jitendraphand/aquabot/docs/images/aquabot_front.png

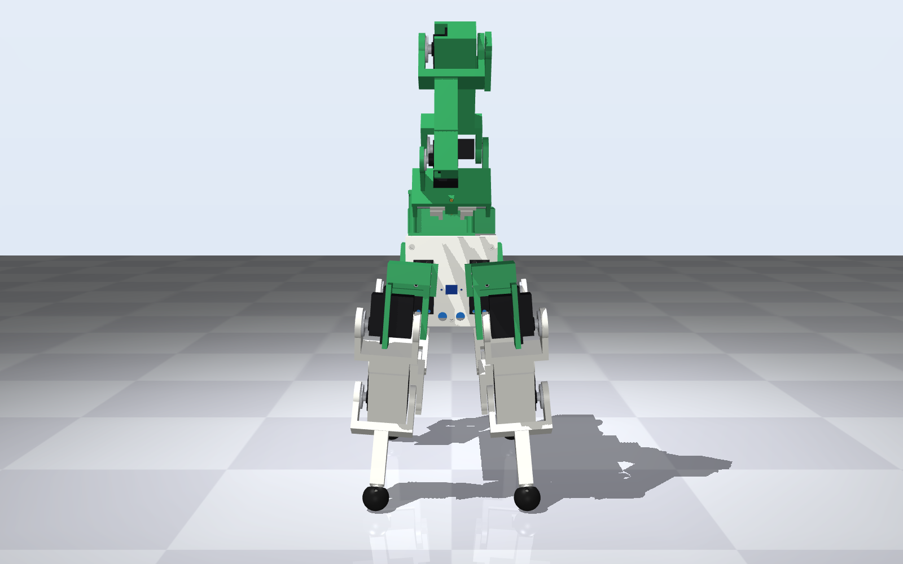
docs/images/aquabot_front.png
