jitendraphand/aquabot/docs/images/aquabot_rear34.png

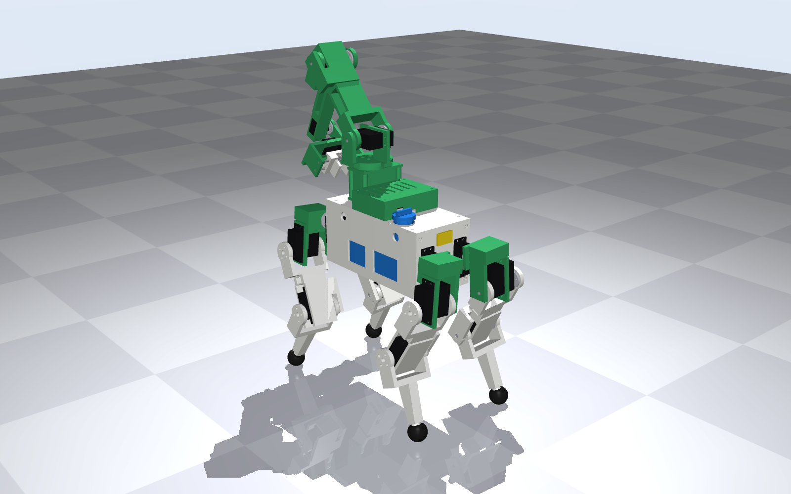
docs/images/aquabot_rear34.png
