jitendraphand/aquabot/docs/images/arm_iso.png

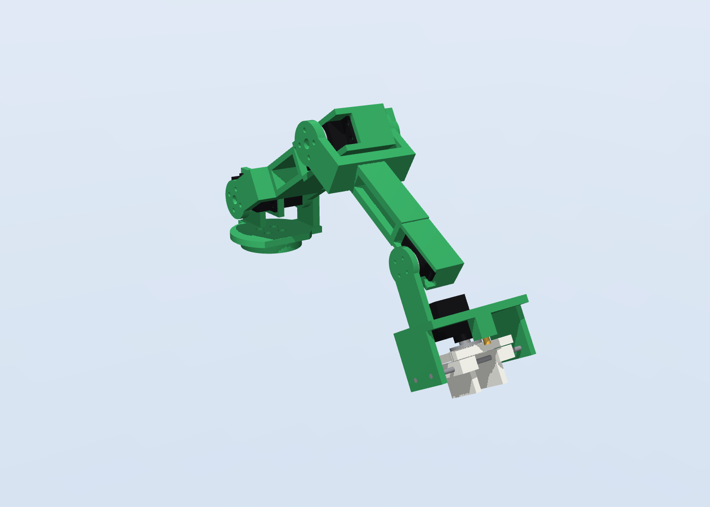
docs/images/arm_iso.png
