jitendraphand/aquabot/docs/images/body_internals_iso.png

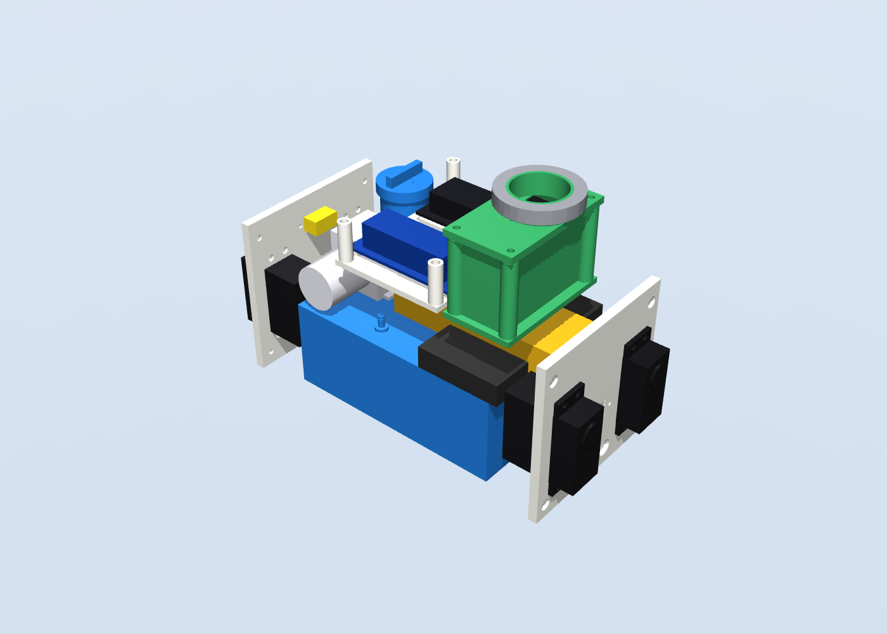
docs/images/body_internals_iso.png
