jitendraphand/aquabot/docs/images/leg_FL_side.png

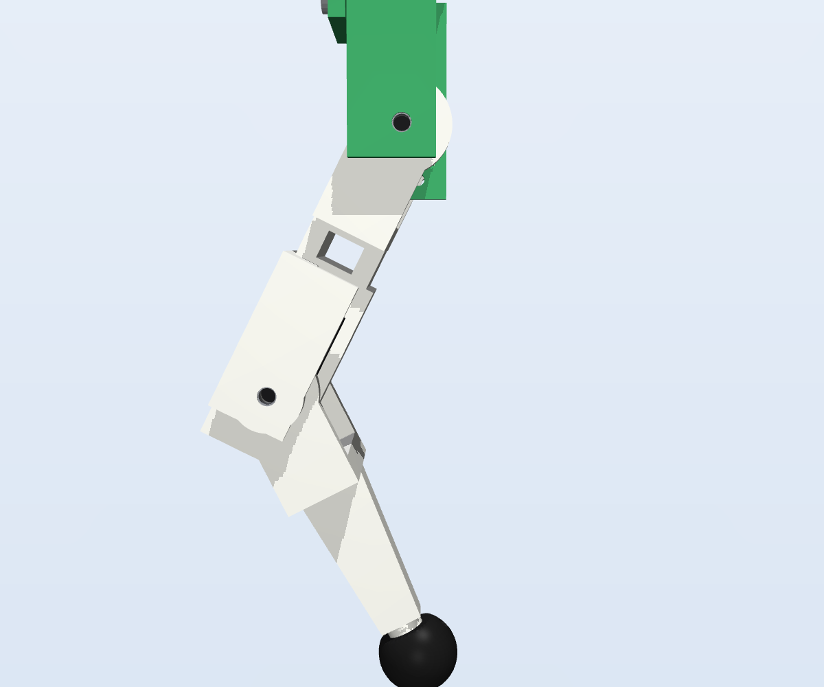
docs/images/leg_FL_side.png
