jitendraphand/aquabot/cad/assembly/arm_assembly.step

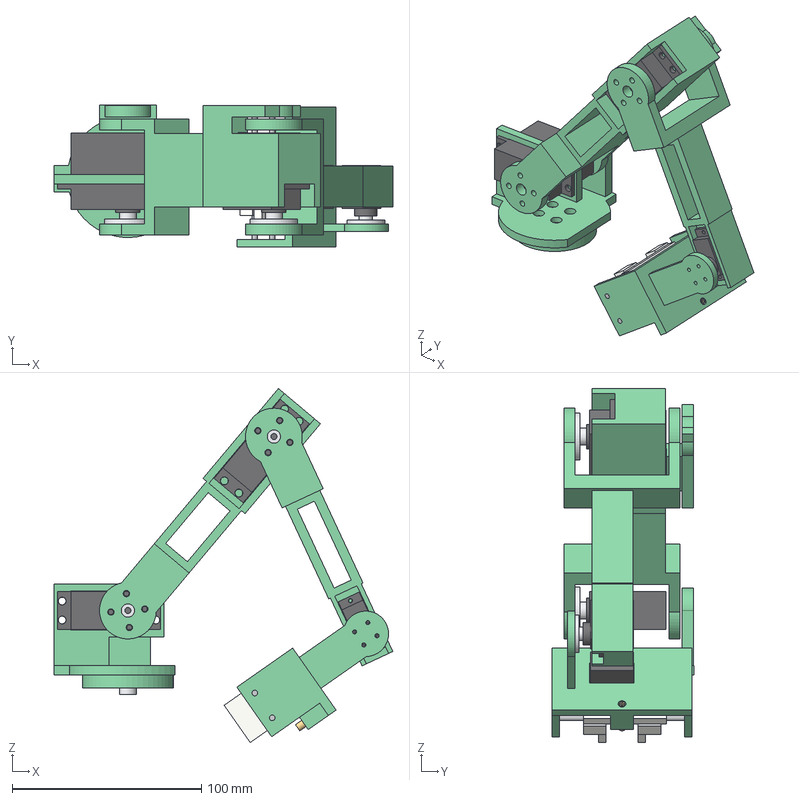
[picture p16: CAD file, 2026-11-04]
cad/assembly/arm_assembly.step
179.0 x 75.0 x 187.1 mm
arm_turntable
horn_arm_yaw x 3
servo_arm_shoulder x 2
bearing_arm_shoulder x 2
upper_arm
forearm
servo_arm_wrist x 2
gripper_base
horn_arm_wrist x 2
rod_gripper_upper x 2
nozzle
gripper_jaw_a x 2
gripper_pinion
