jitendraphand/aquabot/cad/assembly/body_assembly.step

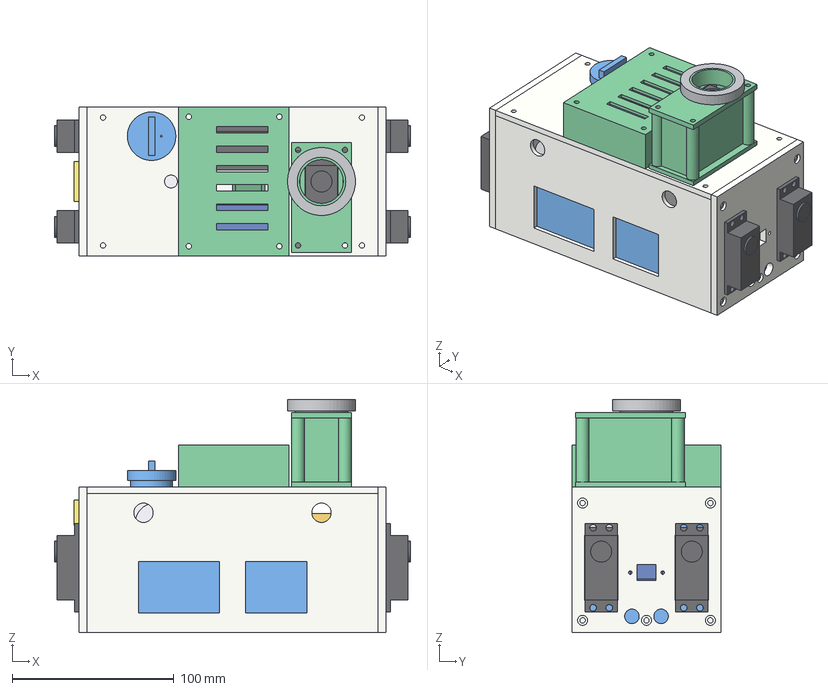
[picture p17: CAD file, 2026-11-04]
cad/assembly/body_assembly.step
220.0 x 92.0 x 144.0 mm
chassis_tub
bulkhead_front
bulkhead_rear
top_deck
tank_body
tank_lid
fill_cap
electronics_tray
electronics_cover
arm_pedestal
arm_bearing_plate
servo_FL_J1 x 5
bearing_yaw
battery
pump
ubec_L x 2
buck_5v
imu
tof
rocker_switch
xt60_port
pca9685
esp32
mosfet
