jitendraphand/aquabot/cad/assembly/aquabot_assembly.step

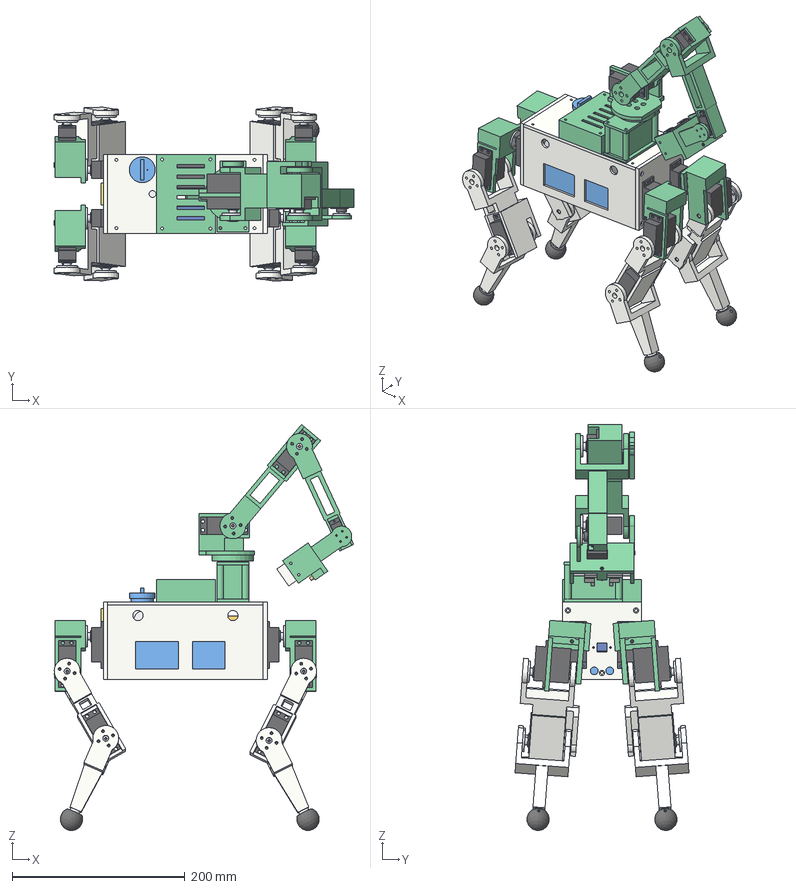
[picture p18: CAD file, 2026-11-04]
cad/assembly/aquabot_assembly.step
347.0 x 201.6 x 470.3 mm
chassis_tub
bulkhead_front
bulkhead_rear
top_deck
tank_body
tank_lid
fill_cap
electronics_tray
electronics_cover
arm_pedestal
arm_bearing_plate
servo_FL_J1 x 15
bearing_yaw
battery
pump
ubec_L x 2
buck_5v
imu
tof
rocker_switch
xt60_port
pca9685
esp32
mosfet
shoulder_bracket_FL x 2
horn_FL_J1 x 15
bearing_FL_J2 x 10
femur_FL x 2
tibia_FL x 2
foot_FL x 4
shoulder_bracket_FR x 2
femur_FR x 2
tibia_FR x 2
arm_turntable
upper_arm
forearm
servo_arm_wrist x 2
gripper_base
horn_arm_wrist x 2
rod_gripper_upper x 2
nozzle
gripper_jaw_a x 2
gripper_pinion
