jitendraphand/aquabot/cad/assembly/leg_FL_assembly.step

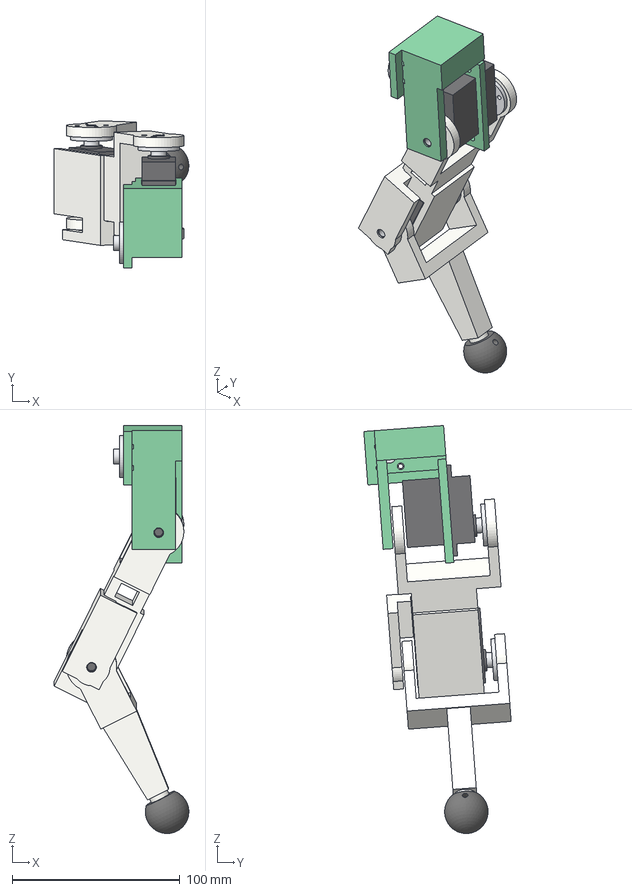
[picture p19: CAD file, 2026-11-04]
cad/assembly/leg_FL_assembly.step
80.4 x 88.0 x 243.5 mm
shoulder_bracket_FL
servo_FL_J2 x 2
horn_FL_J1 x 3
bearing_FL_J2 x 2
femur_FL
tibia_FL
foot_FL
