jitendraphand/aquabot/cad/step/top_deck.step

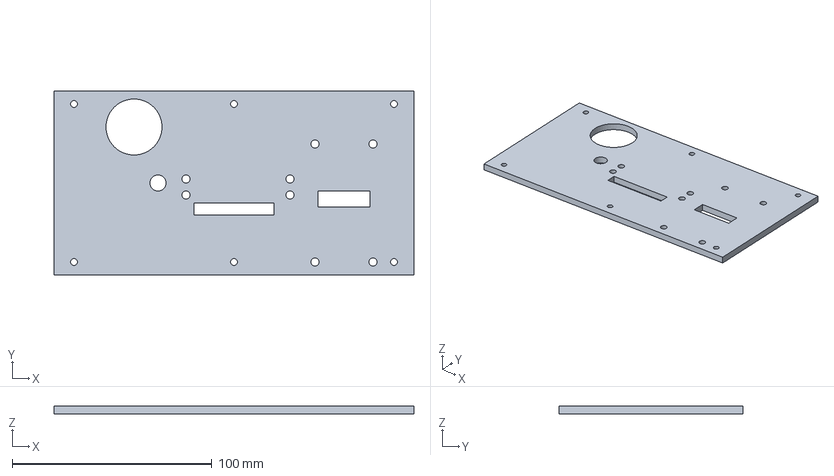
[picture p20: CAD file, 2026-11-04]
cad/step/top_deck.step
180.0 x 92.0 x 4.00 mm
