jitendraphand/aquabot/sim/models/meshes/shoulder_bracket_R.stl

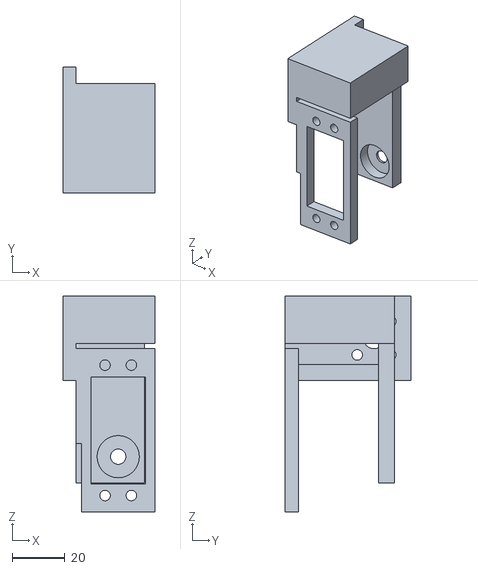
[picture p21: CAD file, 2026-11-04]
sim/models/meshes/shoulder_bracket_R.stl
35.0 x 47.8 x 82.0
