jitendraphand/aquabot/sim/models/urdf/meshes/tank_lid.stl

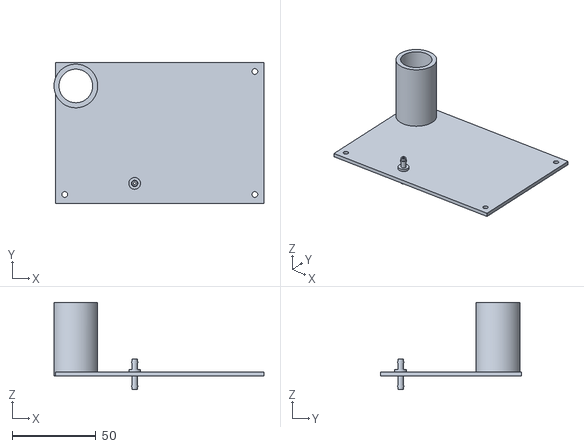
[picture p22: CAD file, 2026-11-04]
sim/models/urdf/meshes/tank_lid.stl
125.0 x 84.0 x 52.0
