jitendraphand/aquabot/cad/step/gripper_pinion.step

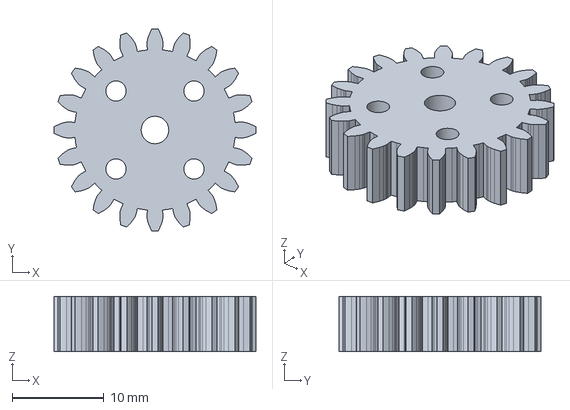
[picture p23: CAD file, 2026-11-04]
cad/step/gripper_pinion.step
22.0 x 22.0 x 6.00 mm
