jitendraphand/aquabot/sim/models/meshes/upper_arm.stl

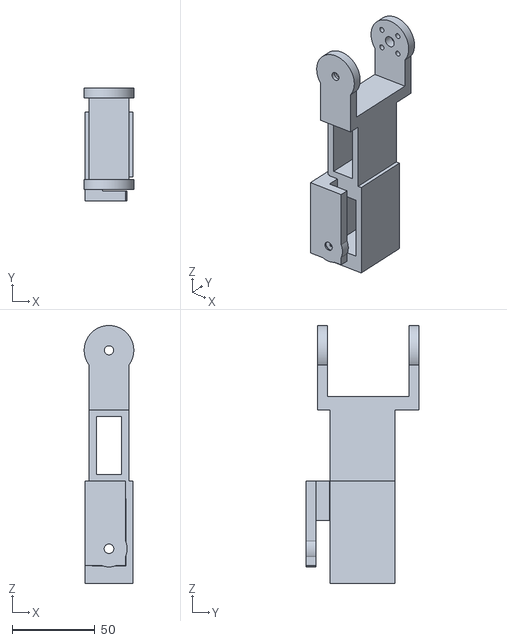
[picture p24: CAD file, 2026-11-04]
sim/models/meshes/upper_arm.stl
30.0 x 68.5 x 156.0
