jitendraphand/aquabot/cad/step/tof_vl53l0x.step

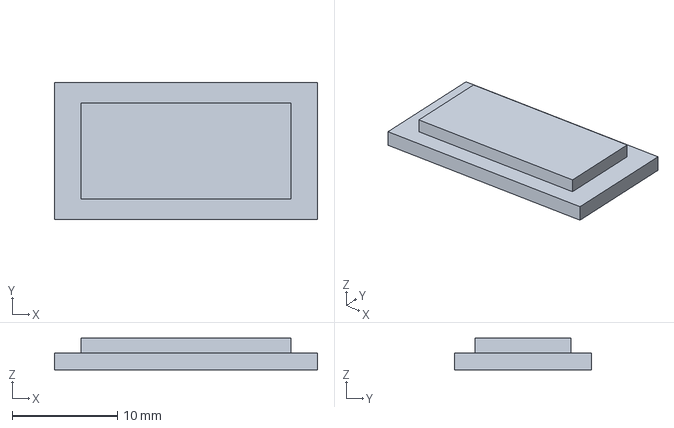
[picture p25: CAD file, 2026-11-04]
cad/step/tof_vl53l0x.step
25.0 x 13.0 x 3.00 mm
