jitendraphand/aquabot/sim/models/meshes/bearing_625.stl

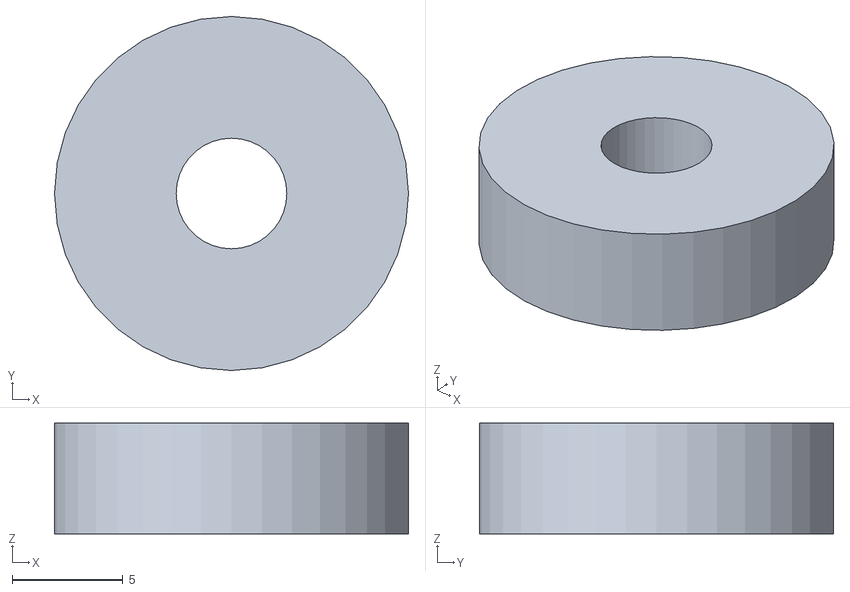
[picture p26: CAD file, 2026-11-04]
sim/models/meshes/bearing_625.stl
16.0 x 16.0 x 5.00
