jitendraphand/aquabot/sim/models/meshes/electronics_cover.stl

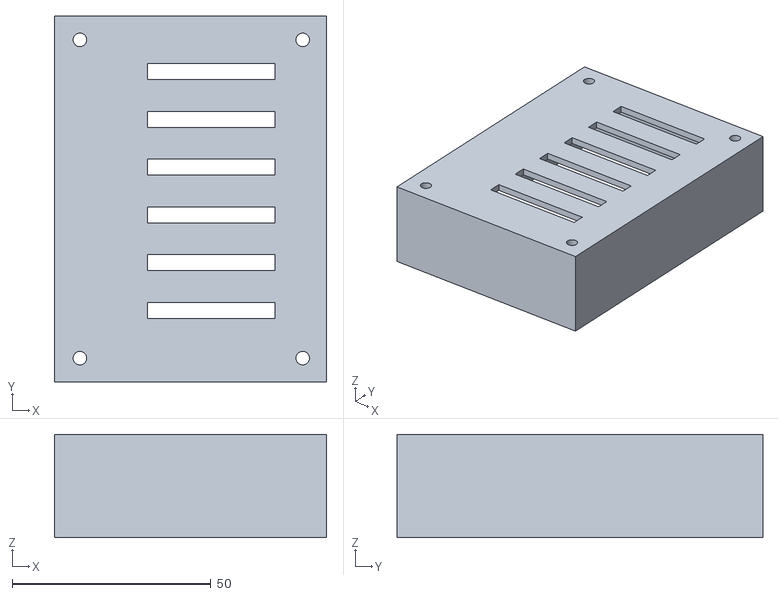
[picture p27: CAD file, 2026-11-04]
sim/models/meshes/electronics_cover.stl
68.4 x 92.0 x 26.0
