jitendraphand/aquabot/sim/models/urdf/meshes/gripper_base.stl

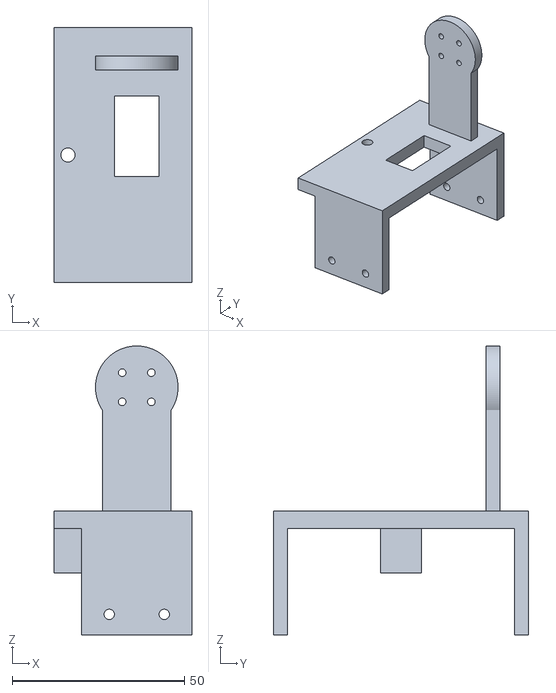
[picture p28: CAD file, 2026-11-04]
sim/models/urdf/meshes/gripper_base.stl
40.0 x 74.0 x 84.0
