jitendraphand/aquabot/cad/step/tibia_L.step

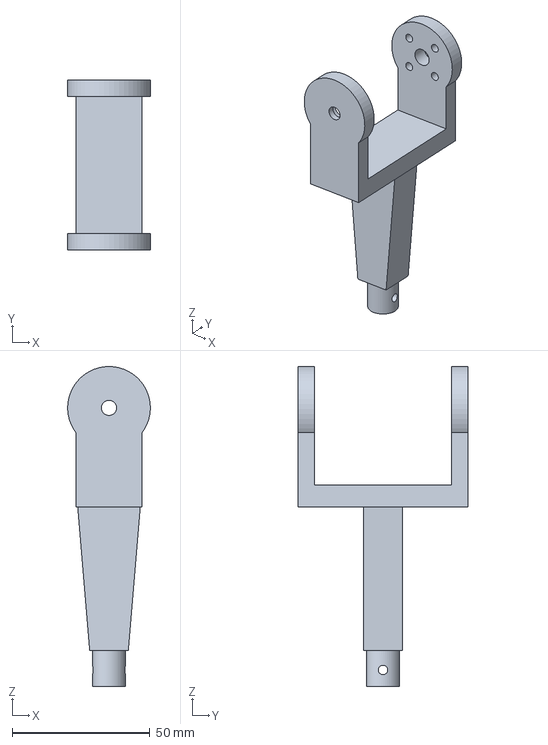
[picture p29: CAD file, 2026-11-04]
cad/step/tibia_L.step
30.0 x 61.5 x 116.0 mm
