jitendraphand/aquabot/sim/models/urdf/meshes/foot_pad.stl

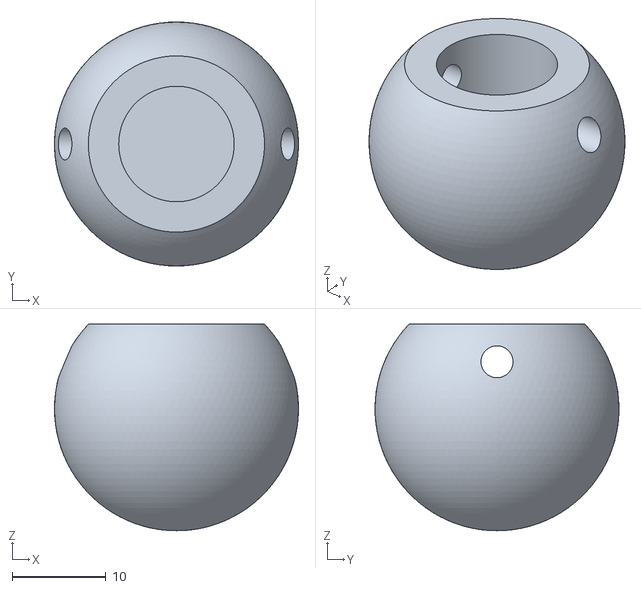
[picture p30: CAD file, 2026-11-04]
sim/models/urdf/meshes/foot_pad.stl
26.0 x 26.0 x 22.0
