jitendraphand/aquabot/cad/step/mosfet_module.step

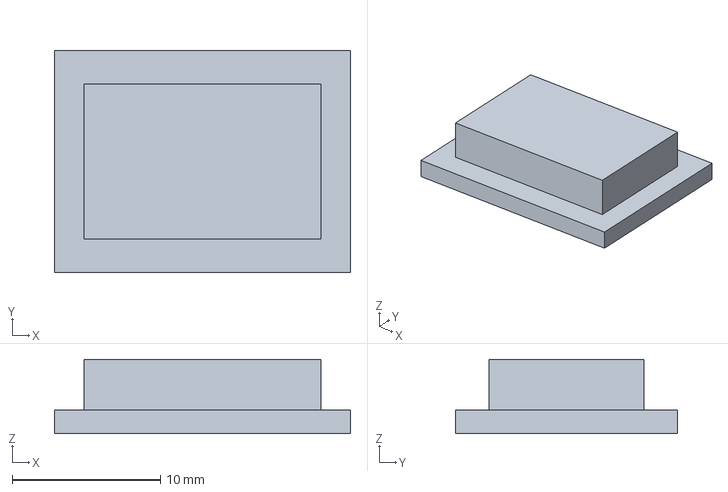
[picture p31: CAD file, 2026-11-04]
cad/step/mosfet_module.step
20.0 x 15.0 x 5.00 mm
