jitendraphand/aquabot/sim/models/meshes/esp32_devkitc.stl

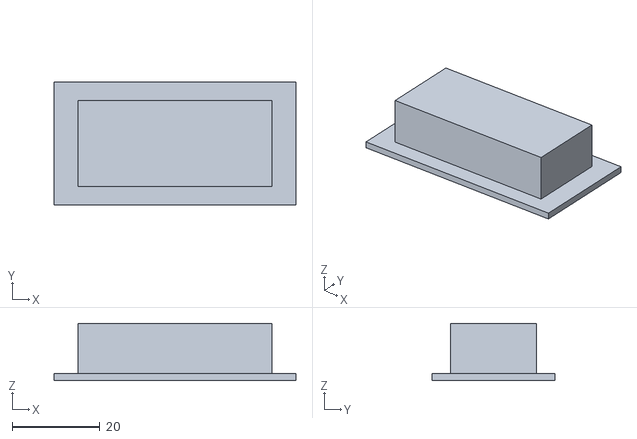
[picture p32: CAD file, 2026-11-04]
sim/models/meshes/esp32_devkitc.stl
55.0 x 28.0 x 13.0
