jitendraphand/aquabot/sim/models/urdf/meshes/bulkhead_front.stl

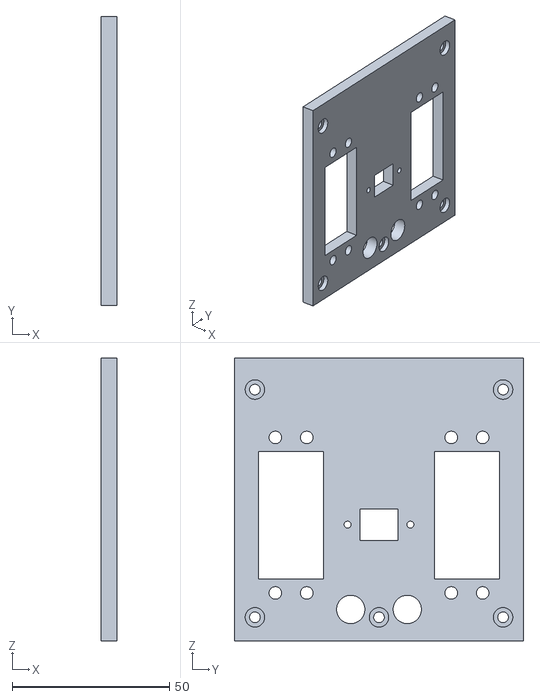
[picture p33: CAD file, 2026-11-04]
sim/models/urdf/meshes/bulkhead_front.stl
5.00 x 92.0 x 90.0
