jitendraphand/aquabot/cad/step/pca9685.step

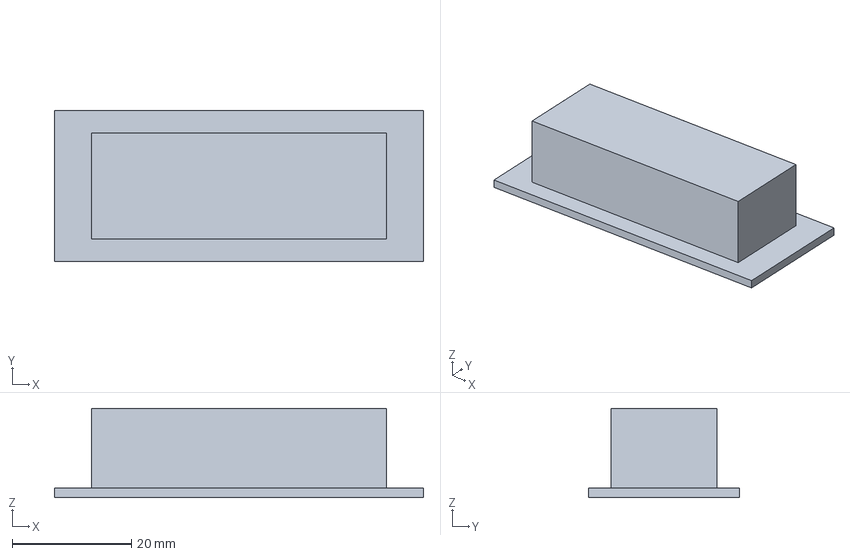
[picture p34: CAD file, 2026-11-04]
cad/step/pca9685.step
62.0 x 25.4 x 15.0 mm
