jitendraphand/aquabot/sim/models/meshes/servo_mg90s.stl

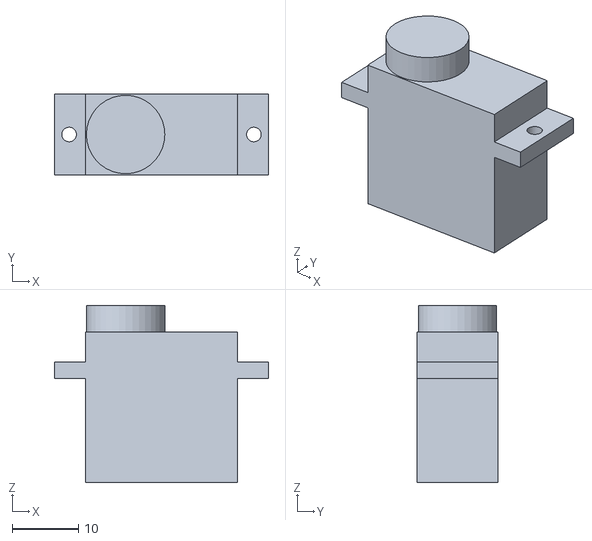
[picture p35: CAD file, 2026-11-04]
sim/models/meshes/servo_mg90s.stl
32.2 x 12.2 x 26.7
