jitendraphand/aquabot/cad/step/ubec_6v_10a.step

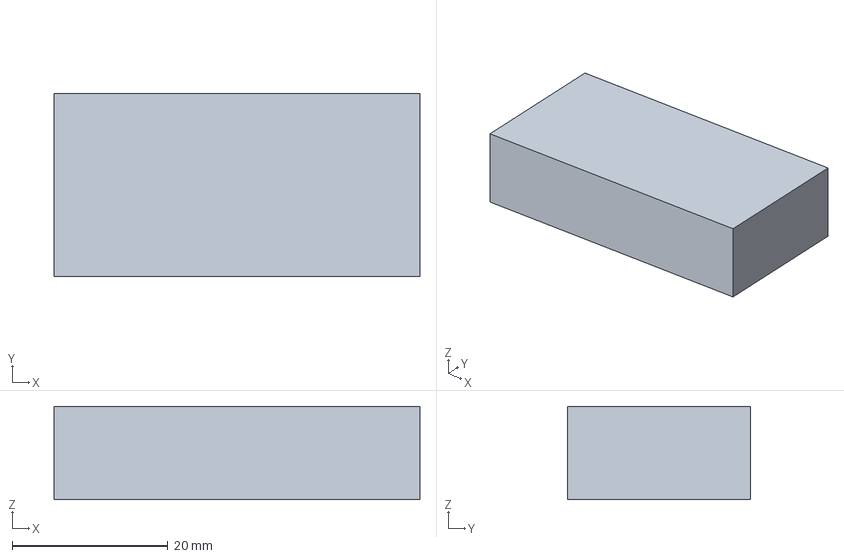
[picture p36: CAD file, 2026-11-04]
cad/step/ubec_6v_10a.step
47.0 x 23.5 x 12.0 mm
