jitendraphand/aquabot/cad/step/arm_bearing_plate.step

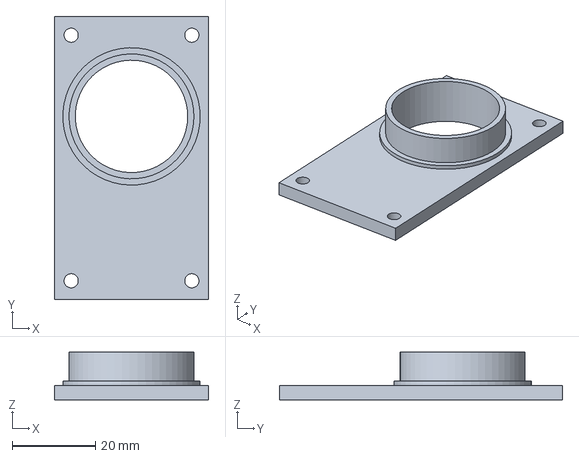
[picture p37: CAD file, 2026-11-04]
cad/step/arm_bearing_plate.step
37.0 x 68.0 x 11.5 mm
