jitendraphand/aquabot/sim/models/urdf/meshes/battery_2s_2200.stl

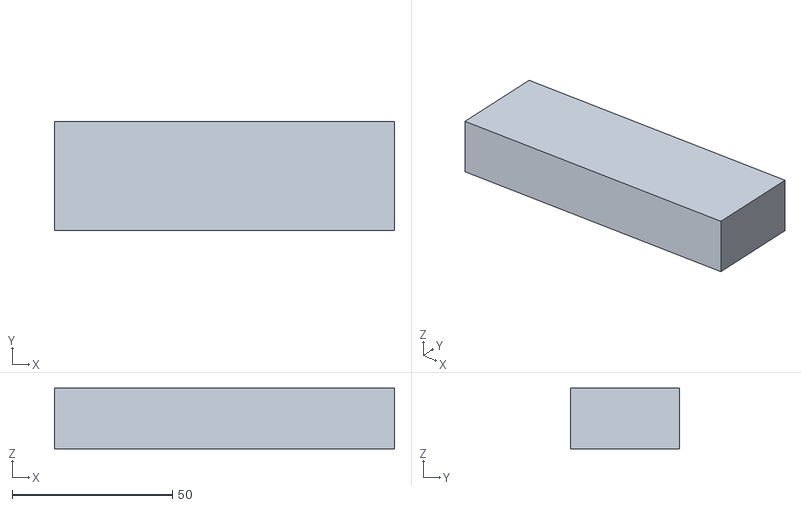
[picture p38: CAD file, 2026-11-04]
sim/models/urdf/meshes/battery_2s_2200.stl
106.0 x 34.0 x 19.0
