jitendraphand/aquabot/cad/step/forearm.step

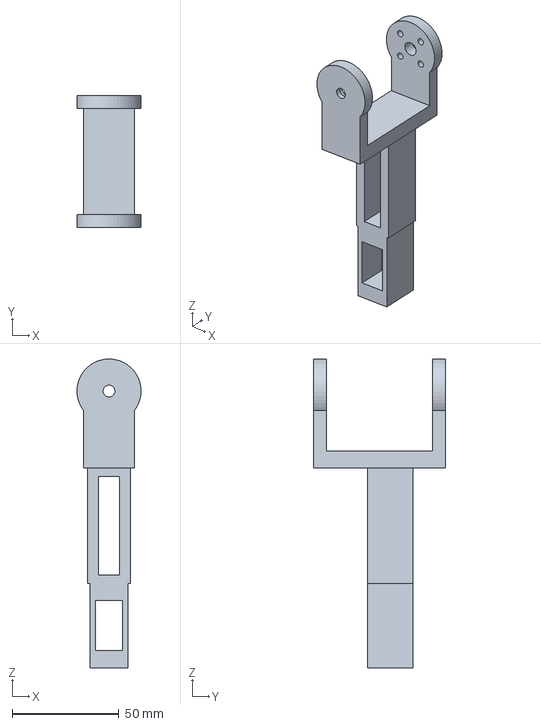
[picture p39: CAD file, 2026-11-04]
cad/step/forearm.step
30.0 x 61.5 x 144.5 mm
