jitendraphand/aquabot/sim/models/meshes/femur_L.stl

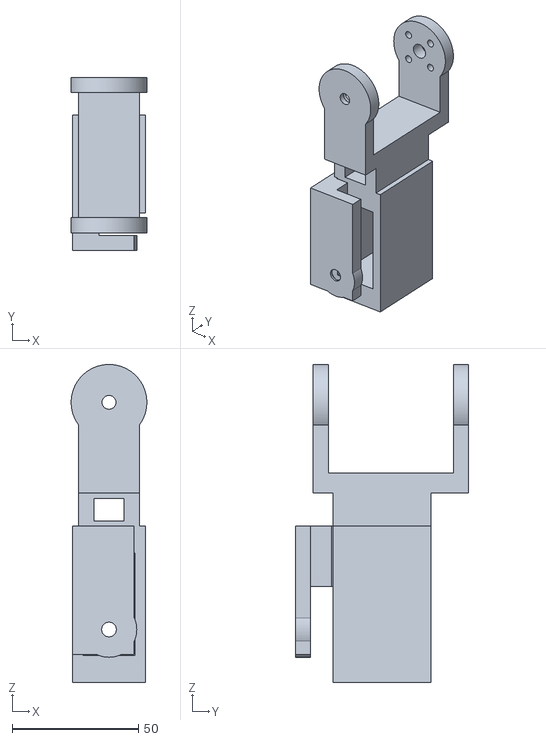
[picture p40: CAD file, 2026-11-04]
sim/models/meshes/femur_L.stl
30.0 x 68.5 x 126.0
