jitendraphand/aquabot/sim/models/urdf/meshes/imu_mpu6050.stl

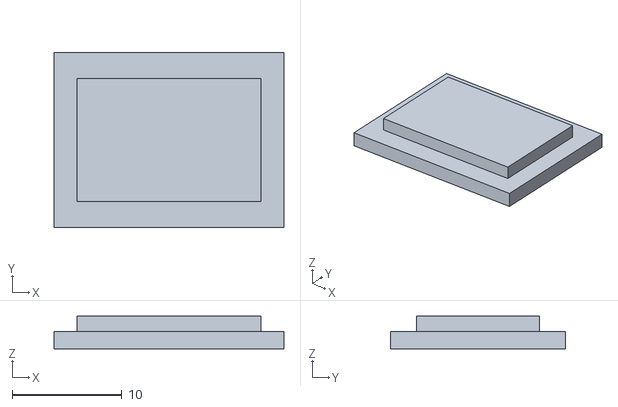
[picture p41: CAD file, 2026-11-04]
sim/models/urdf/meshes/imu_mpu6050.stl
21.0 x 16.0 x 3.00
