jitendraphand/aquabot/cad/step/chassis_tub.step

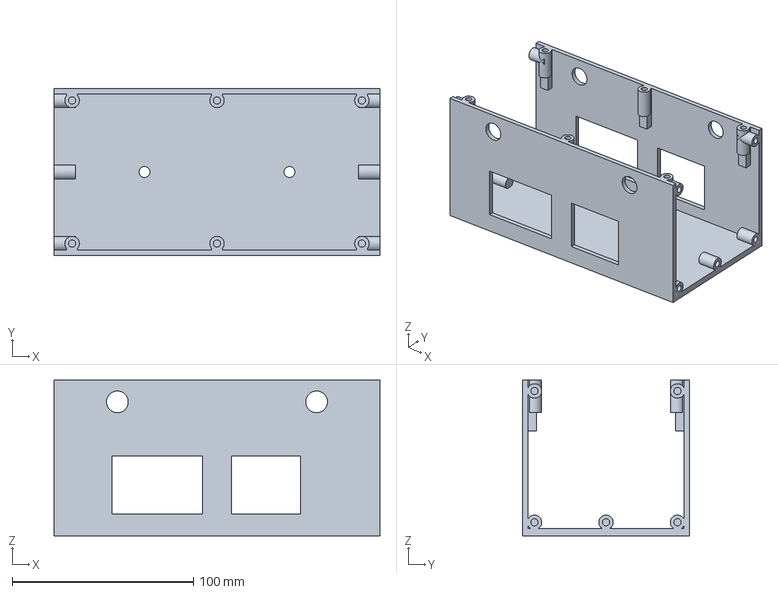
[picture p42: CAD file, 2026-11-04]
cad/step/chassis_tub.step
180.0 x 92.0 x 86.0 mm
