jitendraphand/aquabot/sim/models/urdf/meshes/rocker_switch.stl

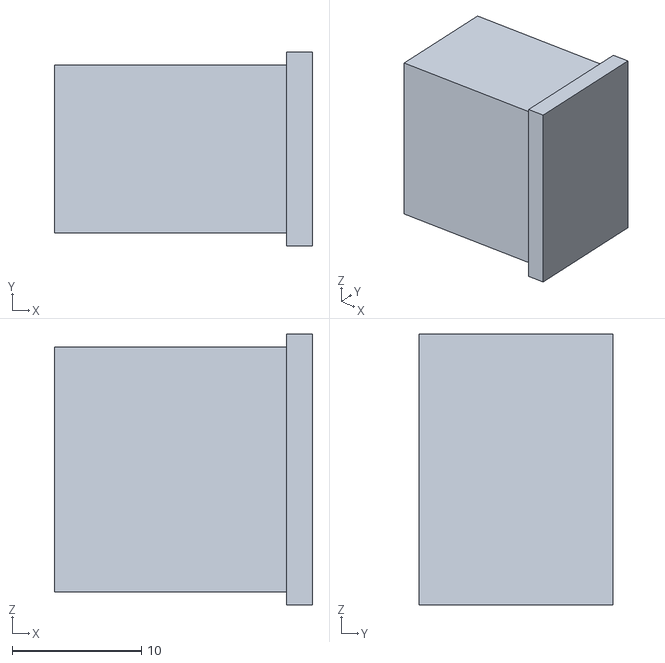
[picture p43: CAD file, 2026-11-04]
sim/models/urdf/meshes/rocker_switch.stl
20.0 x 15.0 x 21.0
