jitendraphand/aquabot/cad/step/servo_ds3218.step

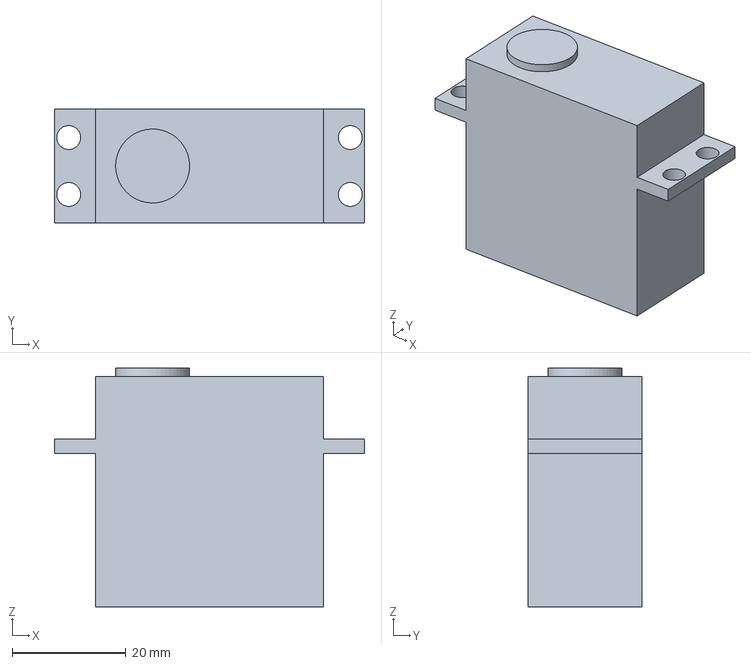
[picture p44: CAD file, 2026-11-04]
cad/step/servo_ds3218.step
54.5 x 20.0 x 42.0 mm
