jitendraphand/aquabot/cad/step/xt60_panel_mount.step

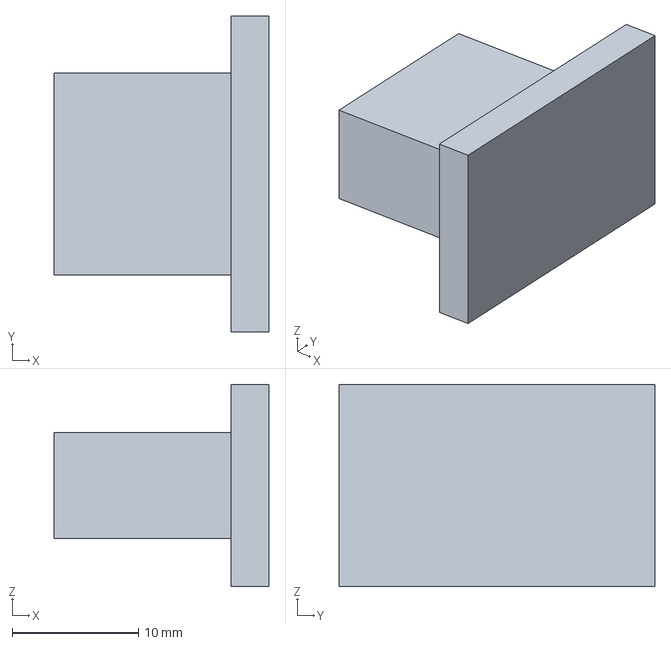
[picture p45: CAD file, 2026-11-04]
cad/step/xt60_panel_mount.step
17.0 x 25.0 x 16.0 mm
