jitendraphand/aquabot/sim/models/urdf/meshes/arm_turntable.stl

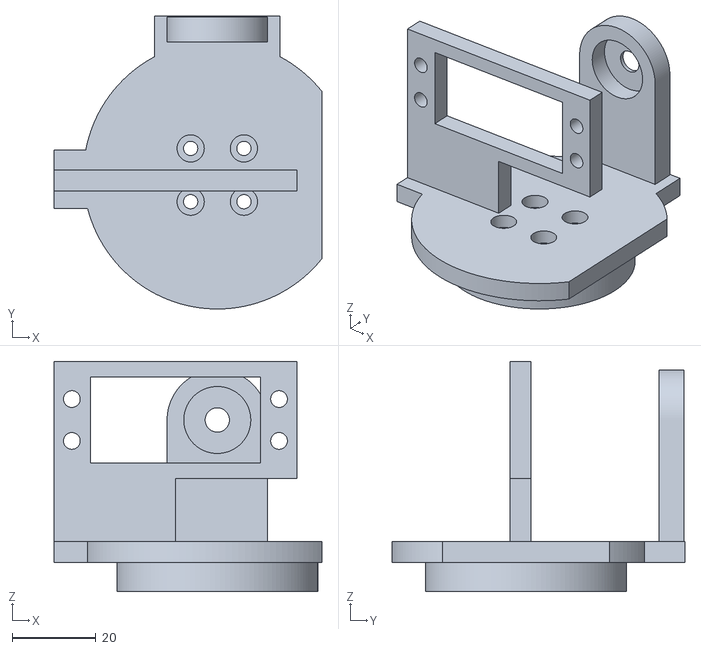
[picture p46: CAD file, 2026-11-04]
sim/models/urdf/meshes/arm_turntable.stl
64.0 x 70.0 x 55.0
