jitendraphand/aquabot/cad/step/pump_peristaltic.step

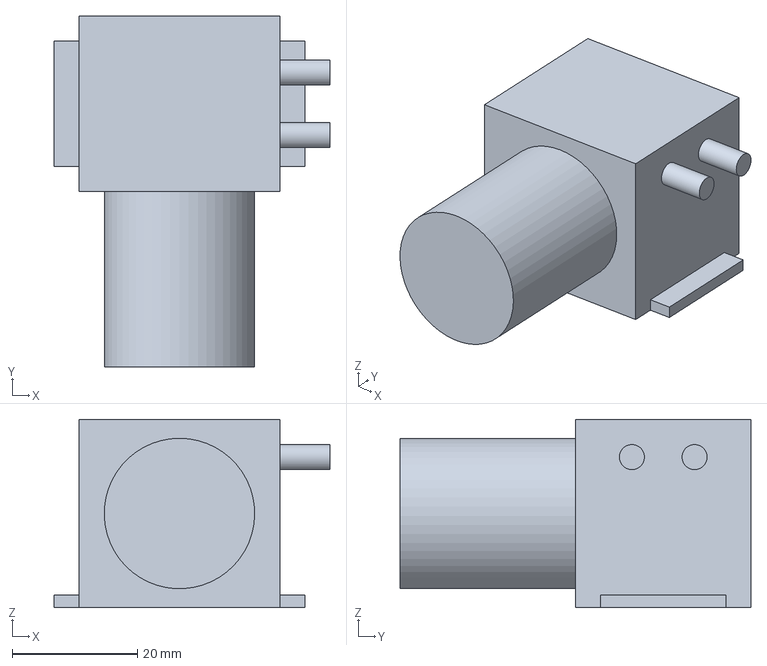
[picture p47: CAD file, 2026-11-04]
cad/step/pump_peristaltic.step
44.0 x 56.0 x 30.0 mm
