jitendraphand/aquabot/sim/models/meshes/fill_cap.stl

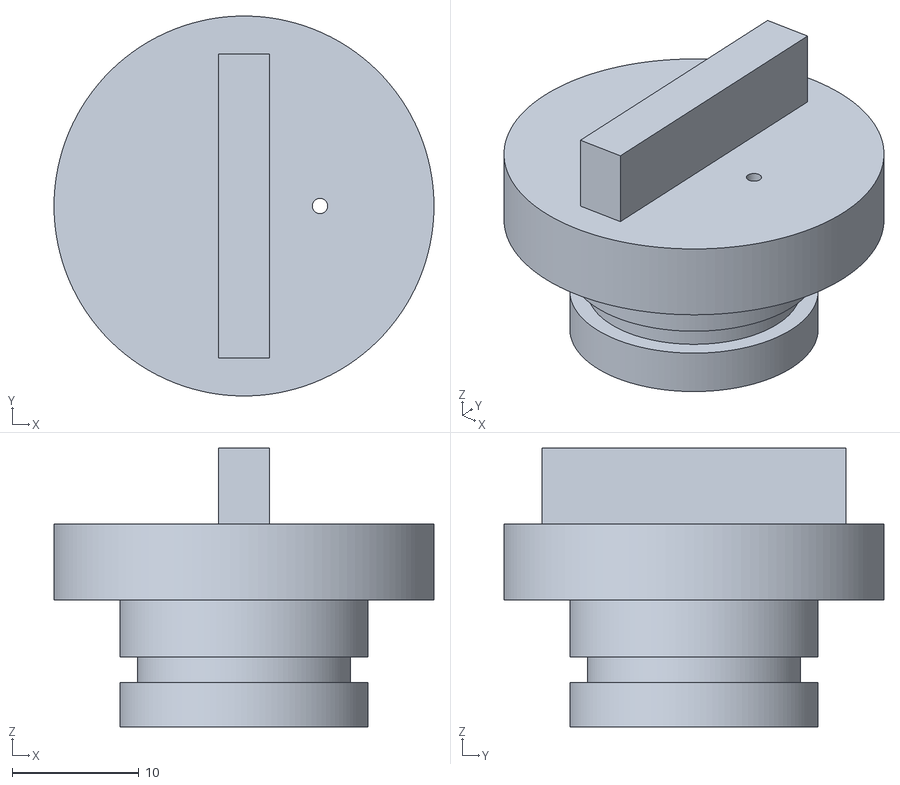
[picture p48: CAD file, 2026-11-04]
sim/models/meshes/fill_cap.stl
30.0 x 30.0 x 22.0
