jitendraphand/aquabot/cad/step/arm_pedestal.step

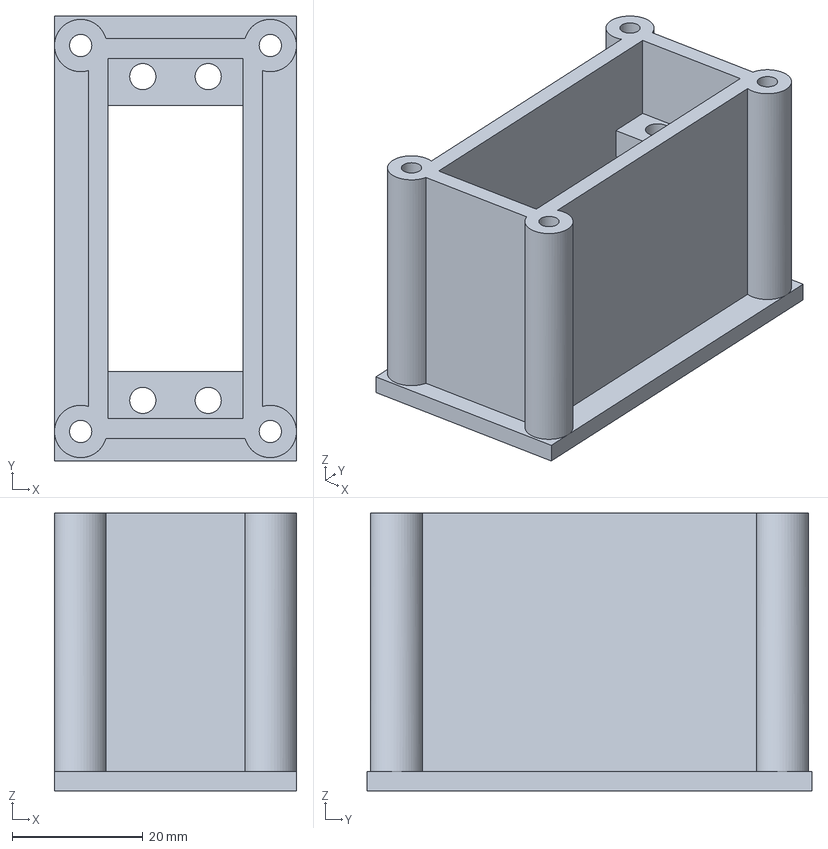
[picture p49: CAD file, 2026-11-04]
cad/step/arm_pedestal.step
37.0 x 68.0 x 42.5 mm
