jitendraphand/aquabot/sim/models/meshes/electronics_tray.stl

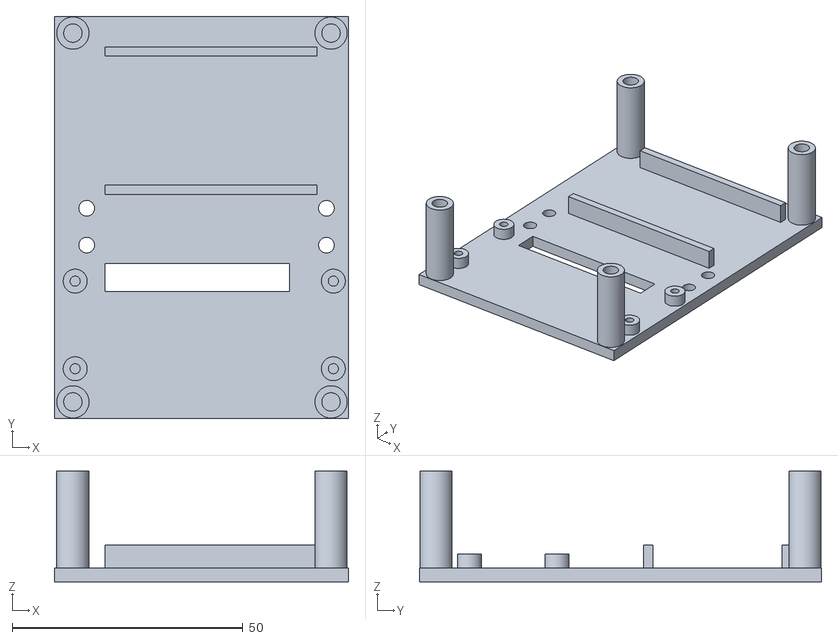
[picture p50: CAD file, 2026-11-04]
sim/models/meshes/electronics_tray.stl
63.8 x 87.2 x 24.0
