jitendraphand/aquabot/cad/step/tank_body.step

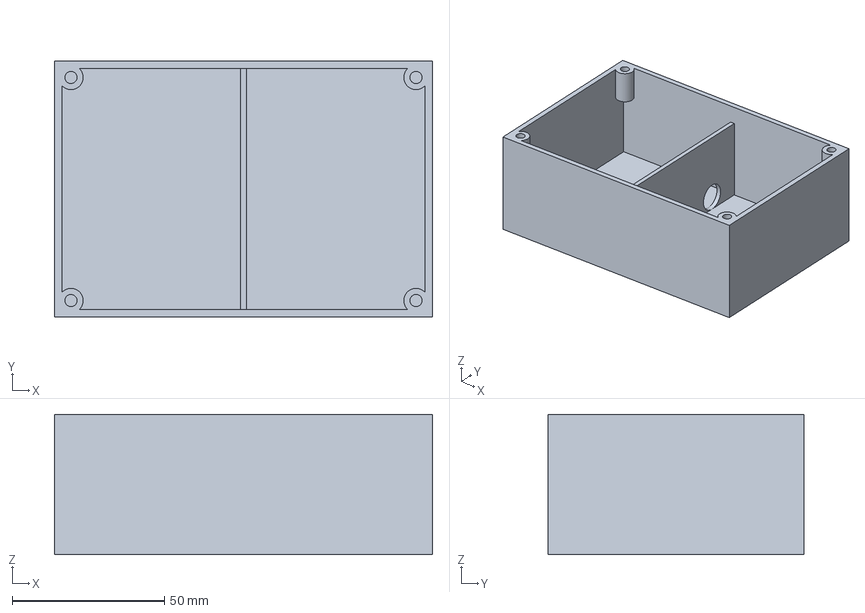
[picture p51: CAD file, 2026-11-04]
cad/step/tank_body.step
124.0 x 84.0 x 46.0 mm
