jitendraphand/aquabot/sim/models/urdf/meshes/horn_mg90s.stl

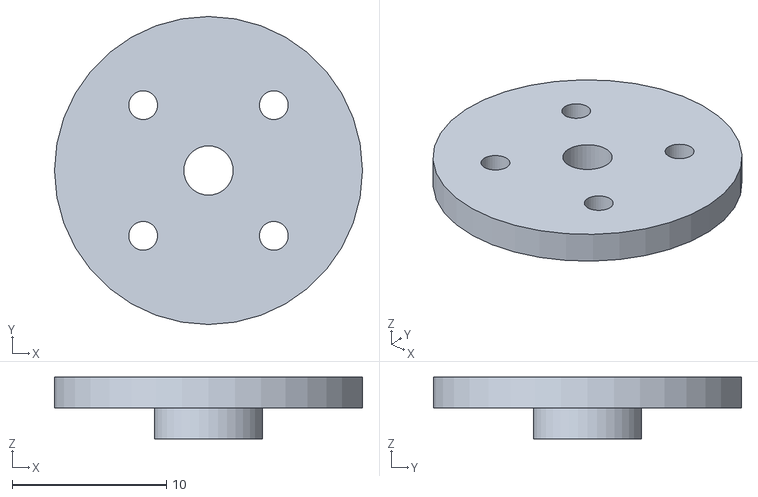
[picture p52: CAD file, 2026-11-04]
sim/models/urdf/meshes/horn_mg90s.stl
20.0 x 20.0 x 4.00
