jitendraphand/aquabot/sim/models/meshes/rod_3x74.stl

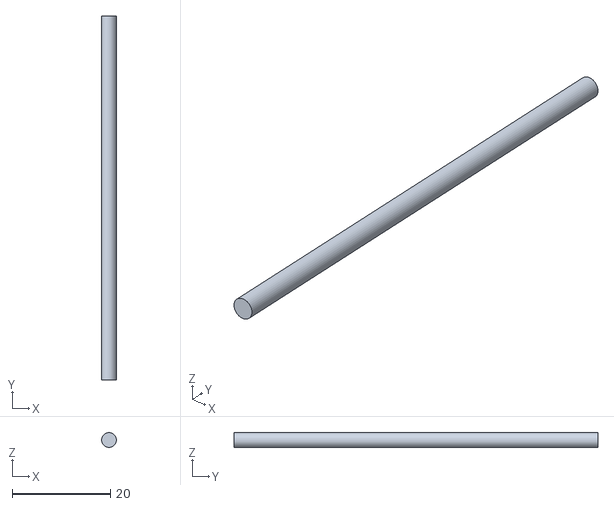
[picture p53: CAD file, 2026-11-04]
sim/models/meshes/rod_3x74.stl
3.00 x 74.0 x 3.00
