jitendraphand/aquabot/sim/models/meshes/horn_ds3218.stl

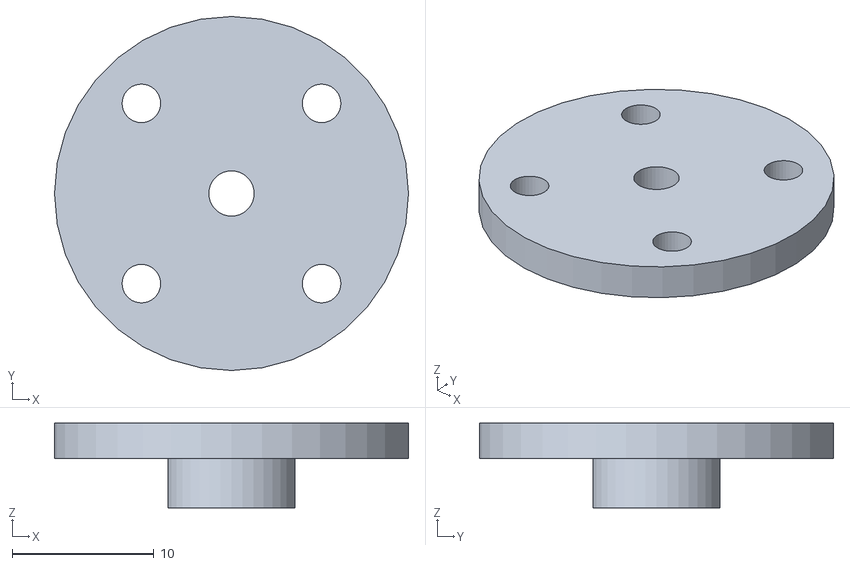
[picture p54: CAD file, 2026-11-04]
sim/models/meshes/horn_ds3218.stl
25.0 x 25.0 x 6.00
