jitendraphand/aquabot/sim/models/urdf/meshes/nozzle_brass.stl

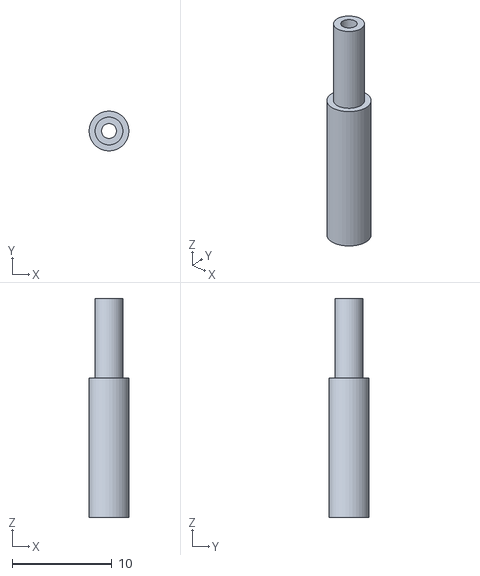
[picture p55: CAD file, 2026-11-04]
sim/models/urdf/meshes/nozzle_brass.stl
4.00 x 4.00 x 22.0
