jitendraphand/aquabot/sim/models/meshes/buck_5v.stl

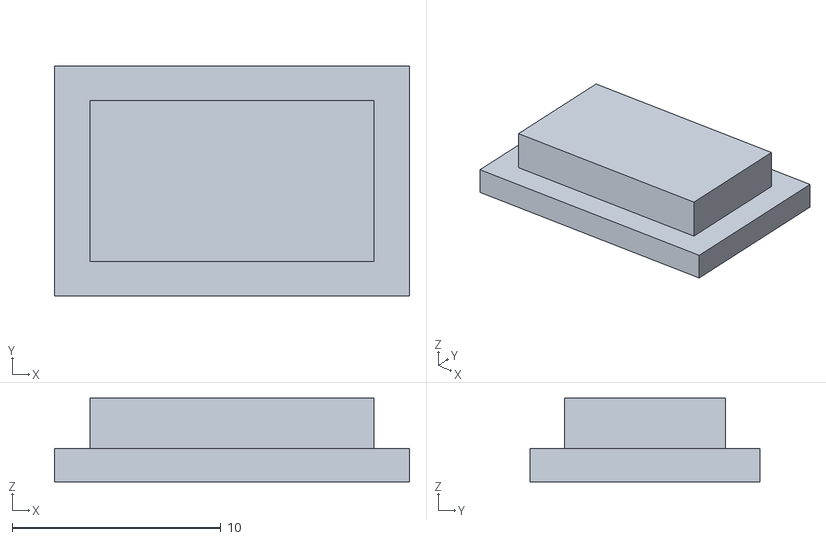
[picture p56: CAD file, 2026-11-04]
sim/models/meshes/buck_5v.stl
17.0 x 11.0 x 4.00
