jitendraphand/aquabot/cad/step/horn_mg90s.step

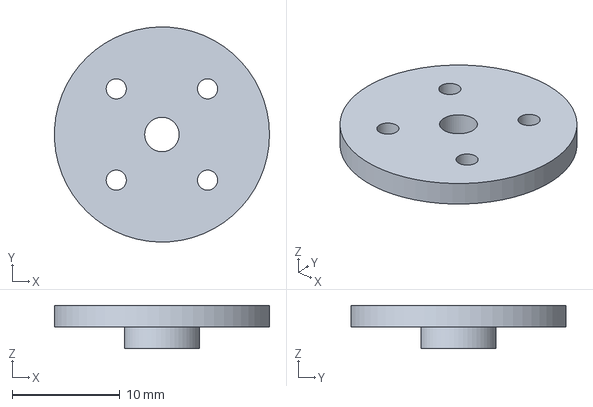
[picture p57: CAD file, 2026-11-04]
cad/step/horn_mg90s.step
20.0 x 20.0 x 4.00 mm
