jitendraphand/aquabot/cad/step/bearing_61806.step

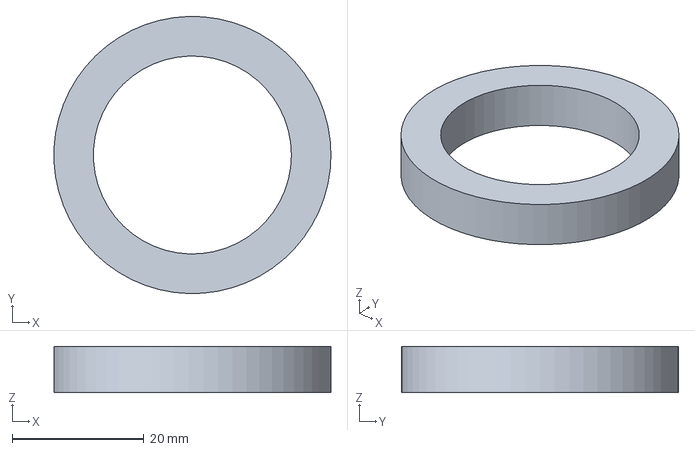
[picture p58: CAD file, 2026-11-04]
cad/step/bearing_61806.step
42.0 x 42.0 x 7.00 mm
