jitendraphand/aquabot/cad/step/gripper_jaw.step

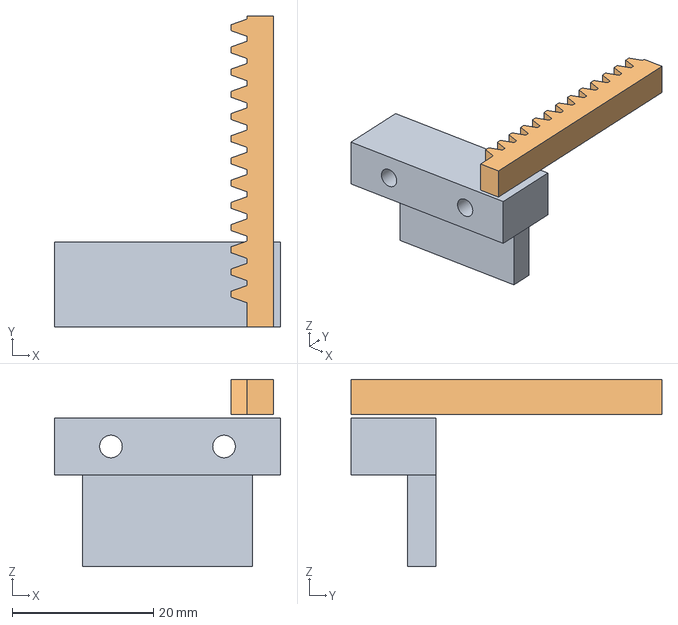
[picture p59: CAD file, 2026-11-04]
cad/step/gripper_jaw.step
32.0 x 44.0 x 26.5 mm
