jitendraphand/aquabot/(list of files, cad)

Other CAD files:
sim/models/urdf/meshes/gripper_pinion.stl
sim/models/urdf/meshes/shoulder_bracket_L.stl
cad/step/shoulder_bracket_L.step
sim/models/meshes/gripper_pinion.stl
sim/models/urdf/meshes/mosfet_module.stl
sim/models/urdf/meshes/bulkhead_rear.stl
sim/models/meshes/mosfet_module.stl
sim/models/meshes/tibia_L.stl
sim/models/urdf/meshes/top_deck.stl
cad/step/gripper_base.step
cad/step/bulkhead_rear.step
sim/models/meshes/bulkhead_rear.stl
sim/models/urdf/meshes/pca9685.stl
cad/step/shoulder_bracket_R.step
sim/models/meshes/arm_bearing_plate.stl
cad/step/foot_pad.step
sim/models/meshes/ubec_6v_10a.stl
sim/models/urdf/meshes/arm_bearing_plate.stl
cad/step/tank_lid.step
sim/models/meshes/servo_ds3218.stl
sim/models/urdf/meshes/tibia_R.stl
sim/models/urdf/meshes/tof_vl53l0x.stl
cad/step/rocker_switch.step
sim/models/meshes/top_deck.stl
cad/step/femur_R.step
cad/step/rod_3x74.step
sim/models/urdf/meshes/ubec_6v_10a.stl
cad/step/bulkhead_front.step
sim/models/meshes/chassis_tub.stl
cad/step/electronics_cover.step
cad/step/femur_L.step
sim/models/meshes/femur_R.stl
sim/models/urdf/meshes/chassis_tub.stl
cad/step/servo_mg90s.step
sim/models/meshes/pump_peristaltic.stl
cad/step/electronics_tray.step
sim/models/meshes/shoulder_bracket_L.stl
cad/step/fill_cap.step
sim/models/urdf/meshes/servo_ds3218.stl
sim/models/meshes/arm_pedestal.stl
sim/models/urdf/meshes/arm_pedestal.stl
cad/step/horn_ds3218.step
sim/models/meshes/forearm.stl
cad/step/nozzle_brass.step
sim/models/urdf/meshes/pump_peristaltic.stl
cad/step/tibia_R.step
sim/models/meshes/xt60_panel_mount.stl
sim/models/urdf/meshes/tank_body.stl
sim/models/meshes/bearing_61806.stl
sim/models/urdf/meshes/xt60_panel_mount.stl
cad/step/bearing_625.step
sim/models/meshes/tof_vl53l0x.stl
sim/models/urdf/meshes/tibia_L.stl
cad/step/imu_mpu6050.step
sim/models/meshes/tank_body.stl
sim/models/urdf/meshes/forearm.stl
cad/step/upper_arm.step
sim/models/meshes/pca9685.stl
cad/step/battery_2s_2200.step
sim/models/meshes/gripper_jaw.stl
sim/models/urdf/meshes/gripper_jaw.stl
cad/step/arm_turntable.step
sim/models/urdf/meshes/femur_R.stl
cad/step/esp32_devkitc.step
sim/models/meshes/tibia_R.stl
cad/step/buck_5v.step
sim/models/urdf/meshes/bearing_61806.stl
cad/stl/arm_bearing_plate.stl
cad/stl/arm_pedestal.stl
cad/stl/arm_turntable.stl
cad/stl/bulkhead_front.stl
cad/stl/bulkhead_rear.stl
cad/stl/chassis_tub.stl
cad/stl/electronics_cover.stl
cad/stl/electronics_tray.stl
cad/stl/femur_L.stl
cad/stl/femur_R.stl
cad/stl/fill_cap.stl
cad/stl/foot_pad.stl
cad/stl/forearm.stl
cad/stl/gripper_base.stl
cad/stl/gripper_jaw.stl
cad/stl/gripper_pinion.stl
cad/stl/shoulder_bracket_L.stl
cad/stl/shoulder_bracket_R.stl
cad/stl/tank_body.stl
cad/stl/tank_lid.stl
cad/stl/tibia_L.stl
cad/stl/tibia_R.stl
cad/stl/top_deck.stl
cad/stl/upper_arm.stl
