jitendraphand/aquabot/qa/QA_REPORT.md

# AquaBot QA / QC report

*Generated by `python -m aquabot.qa.run` on 2026-11-04T11:08:09+00:00 (git `working tree`) in 2.6 min.*

## Result: ✅ ALL CHECKS PASS — 292/292 checks

Verification is hierarchical and recursive: every part is verified before the assembly that uses it, every assembly before its subsystem, and the system-level checks run last. A node passes only if all of its descendants pass.

## Product tree

```
✔ AquaBot v1.0.0  [7 checks]
│  ✔ Body & chassis  [2 checks]
│  │  ✔ chassis_tub  [7 checks]
│  │  ✔ bulkhead_front  [7 checks]
│  │  ✔ bulkhead_rear  [7 checks]
│  │  ✔ top_deck  [7 checks]
│  │  ✔ electronics_tray  [7 checks]
│  │  ✔ electronics_cover  [7 checks]
│  ✔ Water system  [2 checks]
│  │  ✔ tank_body  [7 checks]
│  │  ✔ tank_lid  [7 checks]
│  │  ✔ fill_cap  [7 checks]
│  │  ✔ pump_peristaltic  [3 checks]
│  │  ✔ nozzle_brass  [3 checks]
│  ✔ Legs (×4)  [0 checks]
│  │  ✔ Leg parts  [0 checks]
│  │  │  ✔ shoulder_bracket_L  [7 checks]
│  │  │  ✔ shoulder_bracket_R  [7 checks]
│  │  │  ✔ femur_L  [7 checks]
│  │  │  ✔ femur_R  [7 checks]
│  │  │  ✔ tibia_L  [7 checks]
│  │  │  ✔ tibia_R  [7 checks]
│  │  │  ✔ foot_pad  [7 checks]
│  │  ✔ Leg FL  [6 checks]
│  │  ✔ Leg FR  [6 checks]
│  │  ✔ Leg RL  [6 checks]
│  │  ✔ Leg RR  [6 checks]
│  ✔ Arm & gripper  [4 checks]
│  │  ✔ Pedestal + turntable  [0 checks]
│  │  │  ✔ arm_pedestal  [7 checks]
│  │  │  ✔ arm_bearing_plate  [7 checks]
│  │  │  ✔ arm_turntable  [7 checks]
│  │  ✔ Upper arm + forearm  [0 checks]
│  │  │  ✔ upper_arm  [7 checks]
│  │  │  ✔ forearm  [7 checks]
│  │  ✔ Gripper  [2 checks]
│  │  │  ✔ gripper_base  [7 checks]
│  │  │  ✔ gripper_jaw  [7 checks]
│  │  │  ✔ gripper_pinion  [7 checks]
│  ✔ Purchased components  [0 checks]
│  │  ✔ battery_2s_2200  [3 checks]
│  │  ✔ bearing_61806  [3 checks]
│  │  ✔ bearing_625  [3 checks]
│  │  ✔ buck_5v  [3 checks]
│  │  ✔ esp32_devkitc  [3 checks]
│  │  ✔ horn_ds3218  [3 checks]
│  │  ✔ horn_mg90s  [3 checks]
│  │  ✔ imu_mpu6050  [3 checks]
│  │  ✔ mosfet_module  [3 checks]
│  │  ✔ pca9685  [3 checks]
│  │  ✔ rocker_switch  [3 checks]
│  │  ✔ rod_3x74  [3 checks]
│  │  ✔ servo_ds3218  [3 checks]
│  │  ✔ servo_mg90s  [3 checks]
│  │  ✔ tof_vl53l0x  [3 checks]
│  │  ✔ ubec_6v_10a  [3 checks]
│  │  ✔ xt60_panel_mount  [3 checks]
│  ✔ Kinematics, firmware & models  [9 checks]
│  ✔ BOM & documentation  [6 checks]
│  ✔ Physics simulation (MuJoCo)  [11 checks]
```

## Control-loop iterations

| Iter | Failing checks | Corrective action |
|---:|---|---|
| 1 | — | — |

## All checks

| Node | ID | Check | Result | Value | Limit | Detail |
|---|---|---|:---:|---|---|---|
| AquaBot v1.0.0 | `S-MAS-01` | total mass with full tank | ✅ | 3193.7 | 3200.0 | dry 2794 g |
| AquaBot v1.0.0 | `S-STB-01` | static stability margin, 4-foot stance (all mission configs) | ✅ | 60.2 | 25.0 | stand, full tank, arm stowed: 74 mm; stand, empty tank: 74 mm; arm stow, full tank, 100 g payload: 74 mm; arm water_mid, full tank, 100 g payload: 65 mm; arm pi |
| AquaBot v1.0.0 | `S-STB-02` | crawl gait: planned CoG margin inside support (3+ feet) ≥ 12 mm | ✅ | 20.0 | 12.0 | sampled 720 instants incl. turning |
| AquaBot v1.0.0 | `S-TRQ-01` | leg static torque safety factor (3-foot crawl support) | ✅ | 2.76 | 2.0 | FR lifted=FL τ=[0.711, 0.077, 0.694] N·m (Fz=15.4 N) |
| AquaBot v1.0.0 | `S-TRQ-02` | arm static torque SF at full horizontal reach + 100 g payload | ✅ | 2.15 | 2.0 | shoulder: 0.662 N·m (SF 3.0), elbow: 0.307 N·m (SF 6.4), wrist: 0.101 N·m (SF 2.1) |
| AquaBot v1.0.0 | `S-PWR-01` | estimated mission runtime on one charge (walking continuously) | ✅ | 24.0 | 20.0 | servo rail 4.53 A mean (sim, I∝τ) -> P≈32.6 W from 13.0 Wh usable |
| AquaBot v1.0.0 | `S-PWR-02` | servo rail peak current within 2 × 10 A UBEC rating | ✅ | 9.6 | 20.0 | simulated peak (sum of all servos) |
| Body & chassis | `A-INT-01:body` | exact B-rep interference at nominal pose (OCC boolean) | ✅ | 0 | 0 |  |
| Body & chassis | `A-FAS-01:body` | every fastener hole has a coaxial mating hole | ✅ | 0 | 0 | 360 holes matched overall |
| chassis_tub | `P-GEO-01:chassis_tub` | valid single B-rep solid | ✅ | 1 | 1 |  |
| chassis_tub | `P-GEO-02:chassis_tub` | STEP round-trip volume error | ✅ | 0.0 | 0.001 | chassis_tub.step |
| chassis_tub | `P-GEO-03:chassis_tub` | STL watertight + volume error | ✅ | 1e-05 | 0.015 | watertight=True, faces=18104 |
| chassis_tub | `P-MFG-01:chassis_tub` | fits print bed (some orientation) | ✅ | [86.0, 92.0, 180.0] | [220.0, 220.0, 250.0] |  |
| chassis_tub | `P-MFG-02:chassis_tub` | wall thickness (ray-cast, p1 ≥ 0.8 mm, <6 % below 1.2 mm) | ✅ | {"p01": 1.977, "p05": 2.98, "median": 3.98, "frac_below_1p2": 0.0} | {"p01": 0.8, "frac_below_1p2": 0.06} |  |
| chassis_tub | `P-MFG-03:chassis_tub` | material + print instructions present | ✅ | PETG | null |  |
| chassis_tub | `P-MAS-01:chassis_tub` | estimated mass in plausible range | ✅ | 120.8 | 0.5–250 g |  |
| bulkhead_front | `P-GEO-01:bulkhead_front` | valid single B-rep solid | ✅ | 1 | 1 |  |
| bulkhead_front | `P-GEO-02:bulkhead_front` | STEP round-trip volume error | ✅ | 0.0 | 0.001 | bulkhead_front.step |
| bulkhead_front | `P-GEO-03:bulkhead_front` | STL watertight + volume error | ✅ | 2e-05 | 0.015 | watertight=True, faces=11228 |
| bulkhead_front | `P-MFG-01:bulkhead_front` | fits print bed (some orientation) | ✅ | [5.0, 90.0, 92.0] | [220.0, 220.0, 250.0] |  |
| bulkhead_front | `P-MFG-02:bulkhead_front` | wall thickness (ray-cast, p1 ≥ 0.8 mm, <6 % below 1.2 mm) | ✅ | {"p01": 2.98, "p05": 4.98, "median": 4.98, "frac_below_1p2": 0.0} | {"p01": 0.8, "frac_below_1p2": 0.06} |  |
| bulkhead_front | `P-MFG-03:bulkhead_front` | material + print instructions present | ✅ | PETG | null |  |
| bulkhead_front | `P-MAS-01:bulkhead_front` | estimated mass in plausible range | ✅ | 23.8 | 0.5–250 g |  |
| bulkhead_rear | `P-GEO-01:bulkhead_rear` | valid single B-rep solid | ✅ | 1 | 1 |  |
| bulkhead_rear | `P-GEO-02:bulkhead_rear` | STEP round-trip volume error | ✅ | 0.0 | 0.001 | bulkhead_rear.step |
| bulkhead_rear | `P-GEO-03:bulkhead_rear` | STL watertight + volume error | ✅ | 2e-05 | 0.015 | watertight=True, faces=11248 |
| bulkhead_rear | `P-MFG-01:bulkhead_rear` | fits print bed (some orientation) | ✅ | [5.0, 90.0, 92.0] | [220.0, 220.0, 250.0] |  |
| bulkhead_rear | `P-MFG-02:bulkhead_rear` | wall thickness (ray-cast, p1 ≥ 0.8 mm, <6 % below 1.2 mm) | ✅ | {"p01": 2.485, "p05": 4.98, "median": 4.98, "frac_below_1p2": 0.0} | {"p01": 0.8, "frac_below_1p2": 0.06} |  |
| bulkhead_rear | `P-MFG-03:bulkhead_rear` | material + print instructions present | ✅ | PETG | null |  |
| bulkhead_rear | `P-MAS-01:bulkhead_rear` | estimated mass in plausible range | ✅ | 23.1 | 0.5–250 g |  |
| top_deck | `P-GEO-01:top_deck` | valid single B-rep solid | ✅ | 1 | 1 |  |
| top_deck | `P-GEO-02:top_deck` | STEP round-trip volume error | ✅ | 0.0 | 0.001 | top_deck.step |
| top_deck | `P-GEO-03:top_deck` | STL watertight + volume error | ✅ | 2e-05 | 0.015 | watertight=True, faces=8196 |
| top_deck | `P-MFG-01:top_deck` | fits print bed (some orientation) | ✅ | [4.0, 92.0, 180.0] | [220.0, 220.0, 250.0] |  |
| top_deck | `P-MFG-02:top_deck` | wall thickness (ray-cast, p1 ≥ 0.8 mm, <6 % below 1.2 mm) | ✅ | {"p01": 1.98, "p05": 3.98, "median": 3.98, "frac_below_1p2": 0.0} | {"p01": 0.8, "frac_below_1p2": 0.06} |  |
| top_deck | `P-MFG-03:top_deck` | material + print instructions present | ✅ | PETG | null |  |
| top_deck | `P-MAS-01:top_deck` | estimated mass in plausible range | ✅ | 47.4 | 0.5–250 g |  |
| electronics_tray | `P-GEO-01:electronics_tray` | valid single B-rep solid | ✅ | 1 | 1 |  |
| electronics_tray | `P-GEO-02:electronics_tray` | STEP round-trip volume error | ✅ | 0.0 | 0.001 | electronics_tray.step |
| electronics_tray | `P-GEO-03:electronics_tray` | STL watertight + volume error | ✅ | 6e-05 | 0.015 | watertight=True, faces=10160 |
| electronics_tray | `P-MFG-01:electronics_tray` | fits print bed (some orientation) | ✅ | [24.0, 63.8, 87.2] | [220.0, 220.0, 250.0] |  |
| electronics_tray | `P-MFG-02:electronics_tray` | wall thickness (ray-cast, p1 ≥ 0.8 mm, <6 % below 1.2 mm) | ✅ | {"p01": 1.476, "p05": 1.478, "median": 2.98, "frac_below_1p2": 0.0} | {"p01": 0.8, "frac_below_1p2": 0.06} |  |
| electronics_tray | `P-MFG-03:electronics_tray` | material + print instructions present | ✅ | PETG | null |  |
| electronics_tray | `P-MAS-01:electronics_tray` | estimated mass in plausible range | ✅ | 18.5 | 0.5–250 g |  |
| electronics_cover | `P-GEO-01:electronics_cover` | valid single B-rep solid | ✅ | 1 | 1 |  |
| electronics_cover | `P-GEO-02:electronics_cover` | STEP round-trip volume error | ✅ | 0.0 | 0.001 | electronics_cover.step |
| electronics_cover | `P-GEO-03:electronics_cover` | STL watertight + volume error | ✅ | 0.0 | 0.015 | watertight=True, faces=2216 |
| electronics_cover | `P-MFG-01:electronics_cover` | fits print bed (some orientation) | ✅ | [26.0, 68.4, 92.0] | [220.0, 220.0, 250.0] |  |
| electronics_cover | `P-MFG-02:electronics_cover` | wall thickness (ray-cast, p1 ≥ 0.8 mm, <6 % below 1.2 mm) | ✅ | {"p01": 1.98, "p05": 1.98, "median": 1.98, "frac_below_1p2": 0.0} | {"p01": 0.8, "frac_below_1p2": 0.06} |  |
| electronics_cover | `P-MFG-03:electronics_cover` | material + print instructions present | ✅ | PETG-G | null |  |
| electronics_cover | `P-MAS-01:electronics_cover` | estimated mass in plausible range | ✅ | 29.2 | 0.5–250 g |  |
| Water system | `S-WAT-01` | usable tank volume (CAD cavity minus bosses & baffle) | ✅ | 404.5 | 400.0 |  |
| Water system | `S-WAT-02` | jet exit speed sensible for ballistic aiming (0.5–3 m/s) | ✅ | 0.943 | 0.5–3 | 100.0 ml/min through Ø1.5 mm |
| tank_body | `P-GEO-01:tank_body` | valid single B-rep solid | ✅ | 1 | 1 |  |
| tank_body | `P-GEO-02:tank_body` | STEP round-trip volume error | ✅ | 0.0 | 0.001 | tank_body.step |
| tank_body | `P-GEO-03:tank_body` | STL watertight + volume error | ✅ | 0.0 | 0.015 | watertight=True, faces=4656 |
| tank_body | `P-MFG-01:tank_body` | fits print bed (some orientation) | ✅ | [46.0, 84.0, 124.0] | [220.0, 220.0, 250.0] |  |
| tank_body | `P-MFG-02:tank_body` | wall thickness (ray-cast, p1 ≥ 0.8 mm, <6 % below 1.2 mm) | ✅ | {"p01": 1.98, "p05": 1.98, "median": 2.38, "frac_below_1p2": 0.0} | {"p01": 0.8, "frac_below_1p2": 0.06} |  |
| tank_body | `P-MFG-03:tank_body` | material + print instructions present | ✅ | PETG-B | null |  |
| tank_body | `P-MAS-01:tank_body` | estimated mass in plausible range | ✅ | 94.7 | 0.5–250 g |  |
| tank_lid | `P-GEO-01:tank_lid` | valid single B-rep solid | ✅ | 1 | 1 |  |
| tank_lid | `P-GEO-02:tank_lid` | STEP round-trip volume error | ✅ | 0.0 | 0.001 | tank_lid.step |
| tank_lid | `P-GEO-03:tank_lid` | STL watertight + volume error | ✅ | 0.00012 | 0.015 | watertight=True, faces=6938 |
| tank_lid | `P-MFG-01:tank_lid` | fits print bed (some orientation) | ✅ | [52.0, 84.0, 125.0] | [220.0, 220.0, 250.0] |  |
| tank_lid | `P-MFG-02:tank_lid` | wall thickness (ray-cast, p1 ≥ 0.8 mm, <6 % below 1.2 mm) | ✅ | {"p01": 2.38, "p05": 2.38, "median": 2.38, "frac_below_1p2": 0.0089} | {"p01": 0.8, "frac_below_1p2": 0.06} |  |
| tank_lid | `P-MFG-03:tank_lid` | material + print instructions present | ✅ | PETG-B | null |  |
| tank_lid | `P-MAS-01:tank_lid` | estimated mass in plausible range | ✅ | 42.3 | 0.5–250 g |  |
| fill_cap | `P-GEO-01:fill_cap` | valid single B-rep solid | ✅ | 1 | 1 |  |
| fill_cap | `P-GEO-02:fill_cap` | STEP round-trip volume error | ✅ | 0.0 | 0.001 | fill_cap.step |
| fill_cap | `P-GEO-03:fill_cap` | STL watertight + volume error | ✅ | 0.00038 | 0.015 | watertight=True, faces=2536 |
| fill_cap | `P-MFG-01:fill_cap` | fits print bed (some orientation) | ✅ | [22.0, 30.0, 30.0] | [220.0, 220.0, 250.0] |  |
| fill_cap | `P-MFG-02:fill_cap` | wall thickness (ray-cast, p1 ≥ 0.8 mm, <6 % below 1.2 mm) | ✅ | {"p01": 3.48, "p05": 3.48, "median": 15.98, "frac_below_1p2": 0.0} | {"p01": 0.8, "frac_below_1p2": 0.06} |  |
| fill_cap | `P-MFG-03:fill_cap` | material + print instructions present | ✅ | PETG-B | null |  |
| fill_cap | `P-MAS-01:fill_cap` | estimated mass in plausible range | ✅ | 9.7 | 0.5–250 g |  |
| pump_peristaltic | `P-GEO-01:pump_peristaltic` | valid single B-rep solid | ✅ | 1 | 1 |  |
| pump_peristaltic | `P-GEO-02:pump_peristaltic` | STEP round-trip volume error | ✅ | 0.0 | 0.001 | pump_peristaltic.step |
| pump_peristaltic | `V-DAT-01:pump_peristaltic` | vendor data (mass, description, source) | ✅ | 62.0 | >0 |  |
| nozzle_brass | `P-GEO-01:nozzle_brass` | valid single B-rep solid | ✅ | 1 | 1 |  |
| nozzle_brass | `P-GEO-02:nozzle_brass` | STEP round-trip volume error | ✅ | 0.0 | 0.001 | nozzle_brass.step |
| nozzle_brass | `V-DAT-01:nozzle_brass` | vendor data (mass, description, source) | ✅ | 2.0 | >0 |  |
| shoulder_bracket_L | `P-GEO-01:shoulder_bracket_L` | valid single B-rep solid | ✅ | 1 | 1 |  |
| shoulder_bracket_L | `P-GEO-02:shoulder_bracket_L` | STEP round-trip volume error | ✅ | 0.0 | 0.001 | shoulder_bracket_L.step |
| shoulder_bracket_L | `P-GEO-03:shoulder_bracket_L` | STL watertight + volume error | ✅ | 2e-05 | 0.015 | watertight=True, faces=5700 |
| shoulder_bracket_L | `P-MFG-01:shoulder_bracket_L` | fits print bed (some orientation) | ✅ | [35.0, 47.8, 82.0] | [220.0, 220.0, 250.0] |  |
| shoulder_bracket_L | `P-MFG-02:shoulder_bracket_L` | wall thickness (ray-cast, p1 ≥ 0.8 mm, <6 % below 1.2 mm) | ✅ | {"p01": 0.98, "p05": 3.68, "median": 10.18, "frac_below_1p2": 0.0222} | {"p01": 0.8, "frac_below_1p2": 0.06} |  |
| shoulder_bracket_L | `P-MFG-03:shoulder_bracket_L` | material + print instructions present | ✅ | PETG-G | null |  |
| shoulder_bracket_L | `P-MAS-01:shoulder_bracket_L` | estimated mass in plausible range | ✅ | 26.8 | 0.5–250 g |  |
| shoulder_bracket_R | `P-GEO-01:shoulder_bracket_R` | valid single B-rep solid | ✅ | 1 | 1 |  |
| shoulder_bracket_R | `P-GEO-02:shoulder_bracket_R` | STEP round-trip volume error | ✅ | 0.0 | 0.001 | shoulder_bracket_R.step |
| shoulder_bracket_R | `P-GEO-03:shoulder_bracket_R` | STL watertight + volume error | ✅ | 2e-05 | 0.015 | watertight=True, faces=5700 |
| shoulder_bracket_R | `P-MFG-01:shoulder_bracket_R` | fits print bed (some orientation) | ✅ | [35.0, 47.8, 82.0] | [220.0, 220.0, 250.0] |  |
| shoulder_bracket_R | `P-MFG-02:shoulder_bracket_R` | wall thickness (ray-cast, p1 ≥ 0.8 mm, <6 % below 1.2 mm) | ✅ | {"p01": 0.98, "p05": 3.68, "median": 8.065, "frac_below_1p2": 0.0244} | {"p01": 0.8, "frac_below_1p2": 0.06} |  |
| shoulder_bracket_R | `P-MFG-03:shoulder_bracket_R` | material + print instructions present | ✅ | PETG-G | null |  |
| shoulder_bracket_R | `P-MAS-01:shoulder_bracket_R` | estimated mass in plausible range | ✅ | 26.8 | 0.5–250 g |  |
| femur_L | `P-GEO-01:femur_L` | valid single B-rep solid | ✅ | 1 | 1 |  |
| femur_L | `P-GEO-02:femur_L` | STEP round-trip volume error | ✅ | 0.0 | 0.001 | femur_L.step |
| femur_L | `P-GEO-03:femur_L` | STL watertight + volume error | ✅ | 3e-05 | 0.015 | watertight=True, faces=7584 |
| femur_L | `P-MFG-01:femur_L` | fits print bed (some orientation) | ✅ | [30.0, 68.5, 126.0] | [220.0, 220.0, 250.0] |  |
| femur_L | `P-MFG-02:femur_L` | wall thickness (ray-cast, p1 ≥ 0.8 mm, <6 % below 1.2 mm) | ✅ | {"p01": 1.99, "p05": 4.08, "median": 5.98, "frac_below_1p2": 0.0089} | {"p01": 0.8, "frac_below_1p2": 0.06} |  |
| femur_L | `P-MFG-03:femur_L` | material + print instructions present | ✅ | PETG | null |  |
| femur_L | `P-MAS-01:femur_L` | estimated mass in plausible range | ✅ | 48.2 | 0.5–250 g |  |
| femur_R | `P-GEO-01:femur_R` | valid single B-rep solid | ✅ | 1 | 1 |  |
| femur_R | `P-GEO-02:femur_R` | STEP round-trip volume error | ✅ | 0.0 | 0.001 | femur_R.step |
| femur_R | `P-GEO-03:femur_R` | STL watertight + volume error | ✅ | 3e-05 | 0.015 | watertight=True, faces=7584 |
| femur_R | `P-MFG-01:femur_R` | fits print bed (some orientation) | ✅ | [30.0, 68.5, 126.0] | [220.0, 220.0, 250.0] |  |
| femur_R | `P-MFG-02:femur_R` | wall thickness (ray-cast, p1 ≥ 0.8 mm, <6 % below 1.2 mm) | ✅ | {"p01": 0.98, "p05": 4.08, "median": 5.98, "frac_below_1p2": 0.0144} | {"p01": 0.8, "frac_below_1p2": 0.06} |  |
| femur_R | `P-MFG-03:femur_R` | material + print instructions present | ✅ | PETG | null |  |
| femur_R | `P-MAS-01:femur_R` | estimated mass in plausible range | ✅ | 48.2 | 0.5–250 g |  |
| tibia_L | `P-GEO-01:tibia_L` | valid single B-rep solid | ✅ | 1 | 1 |  |
| tibia_L | `P-GEO-02:tibia_L` | STEP round-trip volume error | ✅ | 0.0 | 0.001 | tibia_L.step |
| tibia_L | `P-GEO-03:tibia_L` | STL watertight + volume error | ✅ | 7e-05 | 0.015 | watertight=True, faces=5464 |
| tibia_L | `P-MFG-01:tibia_L` | fits print bed (some orientation) | ✅ | [30.0, 61.5, 116.0] | [220.0, 220.0, 250.0] |  |
| tibia_L | `P-MFG-02:tibia_L` | wall thickness (ray-cast, p1 ≥ 0.8 mm, <6 % below 1.2 mm) | ✅ | {"p01": 2.48, "p05": 5.98, "median": 11.502, "frac_below_1p2": 0.0} | {"p01": 0.8, "frac_below_1p2": 0.06} |  |
| tibia_L | `P-MFG-03:tibia_L` | material + print instructions present | ✅ | PETG | null |  |
| tibia_L | `P-MAS-01:tibia_L` | estimated mass in plausible range | ✅ | 24.4 | 0.5–250 g |  |
| tibia_R | `P-GEO-01:tibia_R` | valid single B-rep solid | ✅ | 1 | 1 |  |
| tibia_R | `P-GEO-02:tibia_R` | STEP round-trip volume error | ✅ | 0.0 | 0.001 | tibia_R.step |
| tibia_R | `P-GEO-03:tibia_R` | STL watertight + volume error | ✅ | 7e-05 | 0.015 | watertight=True, faces=5464 |
| tibia_R | `P-MFG-01:tibia_R` | fits print bed (some orientation) | ✅ | [30.0, 61.5, 116.0] | [220.0, 220.0, 250.0] |  |
| tibia_R | `P-MFG-02:tibia_R` | wall thickness (ray-cast, p1 ≥ 0.8 mm, <6 % below 1.2 mm) | ✅ | {"p01": 2.48, "p05": 5.98, "median": 11.452, "frac_below_1p2": 0.0} | {"p01": 0.8, "frac_below_1p2": 0.06} |  |
| tibia_R | `P-MFG-03:tibia_R` | material + print instructions present | ✅ | PETG | null |  |
| tibia_R | `P-MAS-01:tibia_R` | estimated mass in plausible range | ✅ | 24.4 | 0.5–250 g |  |
| foot_pad | `P-GEO-01:foot_pad` | valid single B-rep solid | ✅ | 1 | 1 |  |
| foot_pad | `P-GEO-02:foot_pad` | STEP round-trip volume error | ✅ | 0.0 | 0.001 | foot_pad.step |
| foot_pad | `P-GEO-03:foot_pad` | STL watertight + volume error | ✅ | 0.00188 | 0.015 | watertight=True, faces=7996 |
| foot_pad | `P-MFG-01:foot_pad` | fits print bed (some orientation) | ✅ | [22.0, 26.0, 26.0] | [220.0, 220.0, 250.0] |  |
| foot_pad | `P-MFG-02:foot_pad` | wall thickness (ray-cast, p1 ≥ 0.8 mm, <6 % below 1.2 mm) | ✅ | {"p01": 2.29, "p05": 4.082, "median": 6.76, "frac_below_1p2": 0.0056} | {"p01": 0.8, "frac_below_1p2": 0.06} |  |
| foot_pad | `P-MFG-03:foot_pad` | material + print instructions present | ✅ | TPU95A | null |  |
| foot_pad | `P-MAS-01:foot_pad` | estimated mass in plausible range | ✅ | 4.1 | 0.5–250 g |  |
| Leg FL | `A-INT-01:FL` | exact B-rep interference at nominal pose (OCC boolean) | ✅ | 0 | 0 |  |
| Leg FL | `A-FAS-01:FL` | every fastener hole has a coaxial mating hole | ✅ | 0 | 0 | 360 holes matched overall |
| Leg FL | `A-KIN-01:FL` | no self-collision inside joint limits (4×9×9 grid) | ✅ | 0 | 0 | 324 poses clear |
| Leg FL | `A-KIN-02:FL` | operating envelope collision-free vs body & neighbour leg | ✅ | 0 | 0 | 127 poses; clear |
| Leg FL | `A-KIN-03:FL` | joint-limit margin over gait envelope ≥ 3° | ✅ | 6.06 | 3.0 |  |
| Leg FL | `A-KIN-04:FL` | pick crouch posture inside limits (≥ 1°) and collision-free | ✅ | 1.19 | 1.0 |  |
| Leg FR | `A-INT-01:FR` | exact B-rep interference at nominal pose (OCC boolean) | ✅ | 0 | 0 |  |
| Leg FR | `A-FAS-01:FR` | every fastener hole has a coaxial mating hole | ✅ | 0 | 0 | 360 holes matched overall |
| Leg FR | `A-KIN-01:FR` | no self-collision inside joint limits (4×9×9 grid) | ✅ | 0 | 0 | 324 poses clear |
| Leg FR | `A-KIN-02:FR` | operating envelope collision-free vs body & neighbour leg | ✅ | 0 | 0 | 127 poses; clear |
| Leg FR | `A-KIN-03:FR` | joint-limit margin over gait envelope ≥ 3° | ✅ | 6.11 | 3.0 |  |
| Leg FR | `A-KIN-04:FR` | pick crouch posture inside limits (≥ 1°) and collision-free | ✅ | 14.64 | 1.0 |  |
| Leg RL | `A-INT-01:RL` | exact B-rep interference at nominal pose (OCC boolean) | ✅ | 0 | 0 |  |
| Leg RL | `A-FAS-01:RL` | every fastener hole has a coaxial mating hole | ✅ | 0 | 0 | 360 holes matched overall |
| Leg RL | `A-KIN-01:RL` | no self-collision inside joint limits (4×9×9 grid) | ✅ | 0 | 0 | 324 poses clear |
| Leg RL | `A-KIN-02:RL` | operating envelope collision-free vs body & neighbour leg | ✅ | 0 | 0 | 127 poses; clear |
| Leg RL | `A-KIN-03:RL` | joint-limit margin over gait envelope ≥ 3° | ✅ | 5.15 | 3.0 |  |
| Leg RL | `A-KIN-04:RL` | pick crouch posture inside limits (≥ 1°) and collision-free | ✅ | 1.19 | 1.0 |  |
| Leg RR | `A-INT-01:RR` | exact B-rep interference at nominal pose (OCC boolean) | ✅ | 0 | 0 |  |
| Leg RR | `A-FAS-01:RR` | every fastener hole has a coaxial mating hole | ✅ | 0 | 0 | 360 holes matched overall |
| Leg RR | `A-KIN-01:RR` | no self-collision inside joint limits (4×9×9 grid) | ✅ | 0 | 0 | 324 poses clear |
| Leg RR | `A-KIN-02:RR` | operating envelope collision-free vs body & neighbour leg | ✅ | 0 | 0 | 127 poses; clear |
| Leg RR | `A-KIN-03:RR` | joint-limit margin over gait envelope ≥ 3° | ✅ | 5.13 | 3.0 |  |
| Leg RR | `A-KIN-04:RR` | pick crouch posture inside limits (≥ 1°) and collision-free | ✅ | 14.64 | 1.0 |  |
| Arm & gripper | `A-INT-01:arm` | exact B-rep interference at nominal pose (OCC boolean) | ✅ | 0 | 0 |  |
| Arm & gripper | `A-FAS-01:arm` | every fastener hole has a coaxial mating hole | ✅ | 0 | 0 | 360 holes matched overall |
| Arm & gripper | `A-KIN-01:arm` | adjacent arm links collision-free inside joint limits (7×8×7×2) | ✅ | 0 | 0 | 784 poses clear |
| Arm & gripper | `A-KIN-02:arm` | mission arm poses collision-free vs whole robot | ✅ | 0 | 0 | 6 poses; clear |
| arm_pedestal | `P-GEO-01:arm_pedestal` | valid single B-rep solid | ✅ | 1 | 1 |  |
| arm_pedestal | `P-GEO-02:arm_pedestal` | STEP round-trip volume error | ✅ | 0.0 | 0.001 | arm_pedestal.step |
| arm_pedestal | `P-GEO-03:arm_pedestal` | STL watertight + volume error | ✅ | 5e-05 | 0.015 | watertight=True, faces=5700 |
| arm_pedestal | `P-MFG-01:arm_pedestal` | fits print bed (some orientation) | ✅ | [37.0, 42.5, 68.0] | [220.0, 220.0, 250.0] |  |
| arm_pedestal | `P-MFG-02:arm_pedestal` | wall thickness (ray-cast, p1 ≥ 0.8 mm, <6 % below 1.2 mm) | ✅ | {"p01": 2.274, "p05": 2.276, "median": 2.98, "frac_below_1p2": 0.0} | {"p01": 0.8, "frac_below_1p2": 0.06} |  |
| arm_pedestal | `P-MFG-03:arm_pedestal` | material + print instructions present | ✅ | PETG-G | null |  |
| arm_pedestal | `P-MAS-01:arm_pedestal` | estimated mass in plausible range | ✅ | 26.0 | 0.5–250 g |  |
| arm_bearing_plate | `P-GEO-01:arm_bearing_plate` | valid single B-rep solid | ✅ | 1 | 1 |  |
| arm_bearing_plate | `P-GEO-02:arm_bearing_plate` | STEP round-trip volume error | ✅ | 0.0 | 0.001 | arm_bearing_plate.step |
| arm_bearing_plate | `P-GEO-03:arm_bearing_plate` | STL watertight + volume error | ✅ | 5e-05 | 0.015 | watertight=True, faces=3560 |
| arm_bearing_plate | `P-MFG-01:arm_bearing_plate` | fits print bed (some orientation) | ✅ | [11.6, 37.0, 68.0] | [220.0, 220.0, 250.0] |  |
| arm_bearing_plate | `P-MFG-02:arm_bearing_plate` | wall thickness (ray-cast, p1 ≥ 0.8 mm, <6 % below 1.2 mm) | ✅ | {"p01": 1.476, "p05": 1.476, "median": 3.48, "frac_below_1p2": 0.0} | {"p01": 0.8, "frac_below_1p2": 0.06} |  |
| arm_bearing_plate | `P-MFG-03:arm_bearing_plate` | material + print instructions present | ✅ | PETG-G | null |  |
| arm_bearing_plate | `P-MAS-01:arm_bearing_plate` | estimated mass in plausible range | ✅ | 7.6 | 0.5–250 g |  |
| arm_turntable | `P-GEO-01:arm_turntable` | valid single B-rep solid | ✅ | 1 | 1 |  |
| arm_turntable | `P-GEO-02:arm_turntable` | STEP round-trip volume error | ✅ | 0.0 | 0.001 | arm_turntable.step |
| arm_turntable | `P-GEO-03:arm_turntable` | STL watertight + volume error | ✅ | 0.00017 | 0.015 | watertight=True, faces=9728 |
| arm_turntable | `P-MFG-01:arm_turntable` | fits print bed (some orientation) | ✅ | [55.0, 64.0, 70.0] | [220.0, 220.0, 250.0] |  |
| arm_turntable | `P-MFG-02:arm_turntable` | wall thickness (ray-cast, p1 ≥ 0.8 mm, <6 % below 1.2 mm) | ✅ | {"p01": 0.98, "p05": 2.972, "median": 4.98, "frac_below_1p2": 0.0156} | {"p01": 0.8, "frac_below_1p2": 0.06} |  |
| arm_turntable | `P-MFG-03:arm_turntable` | material + print instructions present | ✅ | PETG-G | null |  |
| arm_turntable | `P-MAS-01:arm_turntable` | estimated mass in plausible range | ✅ | 24.1 | 0.5–250 g |  |
| upper_arm | `P-GEO-01:upper_arm` | valid single B-rep solid | ✅ | 1 | 1 |  |
| upper_arm | `P-GEO-02:upper_arm` | STEP round-trip volume error | ✅ | 0.0 | 0.001 | upper_arm.step |
| upper_arm | `P-GEO-03:upper_arm` | STL watertight + volume error | ✅ | 2e-05 | 0.015 | watertight=True, faces=7584 |
| upper_arm | `P-MFG-01:upper_arm` | fits print bed (some orientation) | ✅ | [30.0, 68.5, 156.0] | [220.0, 220.0, 250.0] |  |
| upper_arm | `P-MFG-02:upper_arm` | wall thickness (ray-cast, p1 ≥ 0.8 mm, <6 % below 1.2 mm) | ✅ | {"p01": 0.98, "p05": 4.08, "median": 5.98, "frac_below_1p2": 0.0122} | {"p01": 0.8, "frac_below_1p2": 0.06} |  |
| upper_arm | `P-MFG-03:upper_arm` | material + print instructions present | ✅ | PETG-G | null |  |
| upper_arm | `P-MAS-01:upper_arm` | estimated mass in plausible range | ✅ | 56.4 | 0.5–250 g |  |
| forearm | `P-GEO-01:forearm` | valid single B-rep solid | ✅ | 1 | 1 |  |
| forearm | `P-GEO-02:forearm` | STEP round-trip volume error | ✅ | 0.0 | 0.001 | forearm.step |
| forearm | `P-GEO-03:forearm` | STL watertight + volume error | ✅ | 5e-05 | 0.015 | watertight=True, faces=5380 |
| forearm | `P-MFG-01:forearm` | fits print bed (some orientation) | ✅ | [30.0, 61.5, 144.5] | [220.0, 220.0, 250.0] |  |
| forearm | `P-MFG-02:forearm` | wall thickness (ray-cast, p1 ≥ 0.8 mm, <6 % below 1.2 mm) | ✅ | {"p01": 2.48, "p05": 2.58, "median": 5.98, "frac_below_1p2": 0.0} | {"p01": 0.8, "frac_below_1p2": 0.06} |  |
| forearm | `P-MFG-03:forearm` | material + print instructions present | ✅ | PETG-G | null |  |
| forearm | `P-MAS-01:forearm` | estimated mass in plausible range | ✅ | 31.2 | 0.5–250 g |  |
| Gripper | `A-GRP-01:gripper` | rack/pinion geometry consistent; stroke within servo range | ✅ | 114.6 | 180.0 | pitch radius 10.0 mm, opening 41 mm max |
| Gripper | `A-GRP-02:gripper` | grip force ≥ 2× payload slip force (μ=0.6) | ✅ | 21.6 | 1.64 | MG90S stall 0.216 N·m / r 10.0 mm |
| gripper_base | `P-GEO-01:gripper_base` | valid single B-rep solid | ✅ | 1 | 1 |  |
| gripper_base | `P-GEO-02:gripper_base` | STEP round-trip volume error | ✅ | 0.0 | 0.001 | gripper_base.step |
| gripper_base | `P-GEO-03:gripper_base` | STL watertight + volume error | ✅ | 1e-05 | 0.015 | watertight=True, faces=6012 |
| gripper_base | `P-MFG-01:gripper_base` | fits print bed (some orientation) | ✅ | [40.0, 74.0, 84.0] | [220.0, 220.0, 250.0] |  |
| gripper_base | `P-MFG-02:gripper_base` | wall thickness (ray-cast, p1 ≥ 0.8 mm, <6 % below 1.2 mm) | ✅ | {"p01": 2.032, "p05": 3.98, "median": 4.98, "frac_below_1p2": 0.0} | {"p01": 0.8, "frac_below_1p2": 0.06} |  |
| gripper_base | `P-MFG-03:gripper_base` | material + print instructions present | ✅ | PETG-G | null |  |
| gripper_base | `P-MAS-01:gripper_base` | estimated mass in plausible range | ✅ | 20.2 | 0.5–250 g |  |
| gripper_jaw | `P-GEO-01:gripper_jaw` | valid single B-rep solid | ✅ | 1 | 1 |  |
| gripper_jaw | `P-GEO-02:gripper_jaw` | STEP round-trip volume error | ✅ | 0.0 | 0.001 | gripper_jaw.step |
| gripper_jaw | `P-GEO-03:gripper_jaw` | STL watertight + volume error | ✅ | 2e-05 | 0.015 | watertight=True, faces=1264 |
| gripper_jaw | `P-MFG-01:gripper_jaw` | fits print bed (some orientation) | ✅ | [26.5, 32.0, 44.0] | [220.0, 220.0, 250.0] |  |
| gripper_jaw | `P-MFG-02:gripper_jaw` | wall thickness (ray-cast, p1 ≥ 0.8 mm, <6 % below 1.2 mm) | ✅ | {"p01": 1.313, "p05": 2.138, "median": 5.98, "frac_below_1p2": 0.0044} | {"p01": 0.8, "frac_below_1p2": 0.06} |  |
| gripper_jaw | `P-MFG-03:gripper_jaw` | material + print instructions present | ✅ | PETG | null |  |
| gripper_jaw | `P-MAS-01:gripper_jaw` | estimated mass in plausible range | ✅ | 4.5 | 0.5–250 g |  |
| gripper_pinion | `P-GEO-01:gripper_pinion` | valid single B-rep solid | ✅ | 1 | 1 |  |
| gripper_pinion | `P-GEO-02:gripper_pinion` | STEP round-trip volume error | ✅ | 0.0 | 0.001 | gripper_pinion.step |
| gripper_pinion | `P-GEO-03:gripper_pinion` | STL watertight + volume error | ✅ | 3e-05 | 0.015 | watertight=True, faces=3736 |
| gripper_pinion | `P-MFG-01:gripper_pinion` | fits print bed (some orientation) | ✅ | [6.0, 22.0, 22.0] | [220.0, 220.0, 250.0] |  |
| gripper_pinion | `P-MFG-02:gripper_pinion` | wall thickness (ray-cast, p1 ≥ 0.8 mm, <6 % below 1.2 mm) | ✅ | {"p01": 1.08, "p05": 1.318, "median": 5.98, "frac_below_1p2": 0.0311} | {"p01": 0.8, "frac_below_1p2": 0.06} |  |
| gripper_pinion | `P-MFG-03:gripper_pinion` | material + print instructions present | ✅ | PETG | null |  |
| gripper_pinion | `P-MAS-01:gripper_pinion` | estimated mass in plausible range | ✅ | 1.8 | 0.5–250 g |  |
| battery_2s_2200 | `P-GEO-01:battery_2s_2200` | valid single B-rep solid | ✅ | 1 | 1 |  |
| battery_2s_2200 | `P-GEO-02:battery_2s_2200` | STEP round-trip volume error | ✅ | 0.0 | 0.001 | battery_2s_2200.step |
| battery_2s_2200 | `V-DAT-01:battery_2s_2200` | vendor data (mass, description, source) | ✅ | 118.0 | >0 |  |
| bearing_61806 | `P-GEO-01:bearing_61806` | valid single B-rep solid | ✅ | 1 | 1 |  |
| bearing_61806 | `P-GEO-02:bearing_61806` | STEP round-trip volume error | ✅ | 0.0 | 0.001 | bearing_61806.step |
| bearing_61806 | `V-DAT-01:bearing_61806` | vendor data (mass, description, source) | ✅ | 18.0 | >0 |  |
| bearing_625 | `P-GEO-01:bearing_625` | valid single B-rep solid | ✅ | 1 | 1 |  |
| bearing_625 | `P-GEO-02:bearing_625` | STEP round-trip volume error | ✅ | 0.0 | 0.001 | bearing_625.step |
| bearing_625 | `V-DAT-01:bearing_625` | vendor data (mass, description, source) | ✅ | 5.0 | >0 |  |
| buck_5v | `P-GEO-01:buck_5v` | valid single B-rep solid | ✅ | 1 | 1 |  |
| buck_5v | `P-GEO-02:buck_5v` | STEP round-trip volume error | ✅ | 0.0 | 0.001 | buck_5v.step |
| buck_5v | `V-DAT-01:buck_5v` | vendor data (mass, description, source) | ✅ | 2.0 | >0 |  |
| esp32_devkitc | `P-GEO-01:esp32_devkitc` | valid single B-rep solid | ✅ | 1 | 1 |  |
| esp32_devkitc | `P-GEO-02:esp32_devkitc` | STEP round-trip volume error | ✅ | 0.0 | 0.001 | esp32_devkitc.step |
| esp32_devkitc | `V-DAT-01:esp32_devkitc` | vendor data (mass, description, source) | ✅ | 10.0 | >0 |  |
| horn_ds3218 | `P-GEO-01:horn_ds3218` | valid single B-rep solid | ✅ | 1 | 1 |  |
| horn_ds3218 | `P-GEO-02:horn_ds3218` | STEP round-trip volume error | ✅ | 0.0 | 0.001 | horn_ds3218.step |
| horn_ds3218 | `V-DAT-01:horn_ds3218` | vendor data (mass, description, source) | ✅ | 6.0 | >0 |  |
| horn_mg90s | `P-GEO-01:horn_mg90s` | valid single B-rep solid | ✅ | 1 | 1 |  |
| horn_mg90s | `P-GEO-02:horn_mg90s` | STEP round-trip volume error | ✅ | 0.0 | 0.001 | horn_mg90s.step |
| horn_mg90s | `V-DAT-01:horn_mg90s` | vendor data (mass, description, source) | ✅ | 1.5 | >0 |  |
| imu_mpu6050 | `P-GEO-01:imu_mpu6050` | valid single B-rep solid | ✅ | 1 | 1 |  |
| imu_mpu6050 | `P-GEO-02:imu_mpu6050` | STEP round-trip volume error | ✅ | 0.0 | 0.001 | imu_mpu6050.step |
| imu_mpu6050 | `V-DAT-01:imu_mpu6050` | vendor data (mass, description, source) | ✅ | 2.0 | >0 |  |
| mosfet_module | `P-GEO-01:mosfet_module` | valid single B-rep solid | ✅ | 1 | 1 |  |
| mosfet_module | `P-GEO-02:mosfet_module` | STEP round-trip volume error | ✅ | 0.0 | 0.001 | mosfet_module.step |
| mosfet_module | `V-DAT-01:mosfet_module` | vendor data (mass, description, source) | ✅ | 2.0 | >0 |  |
| pca9685 | `P-GEO-01:pca9685` | valid single B-rep solid | ✅ | 1 | 1 |  |
| pca9685 | `P-GEO-02:pca9685` | STEP round-trip volume error | ✅ | 0.0 | 0.001 | pca9685.step |
| pca9685 | `V-DAT-01:pca9685` | vendor data (mass, description, source) | ✅ | 9.0 | >0 |  |
| rocker_switch | `P-GEO-01:rocker_switch` | valid single B-rep solid | ✅ | 1 | 1 |  |
| rocker_switch | `P-GEO-02:rocker_switch` | STEP round-trip volume error | ✅ | 0.0 | 0.001 | rocker_switch.step |
| rocker_switch | `V-DAT-01:rocker_switch` | vendor data (mass, description, source) | ✅ | 4.0 | >0 |  |
| rod_3x74 | `P-GEO-01:rod_3x74` | valid single B-rep solid | ✅ | 1 | 1 |  |
| rod_3x74 | `P-GEO-02:rod_3x74` | STEP round-trip volume error | ✅ | 0.0 | 0.001 | rod_3x74.step |
| rod_3x74 | `V-DAT-01:rod_3x74` | vendor data (mass, description, source) | ✅ | 4.10614 | >0 |  |
| servo_ds3218 | `P-GEO-01:servo_ds3218` | valid single B-rep solid | ✅ | 1 | 1 |  |
| servo_ds3218 | `P-GEO-02:servo_ds3218` | STEP round-trip volume error | ✅ | 0.0 | 0.001 | servo_ds3218.step |
| servo_ds3218 | `V-DAT-01:servo_ds3218` | vendor data (mass, description, source) | ✅ | 60.0 | >0 |  |
| servo_mg90s | `P-GEO-01:servo_mg90s` | valid single B-rep solid | ✅ | 1 | 1 |  |
| servo_mg90s | `P-GEO-02:servo_mg90s` | STEP round-trip volume error | ✅ | 0.0 | 0.001 | servo_mg90s.step |
| servo_mg90s | `V-DAT-01:servo_mg90s` | vendor data (mass, description, source) | ✅ | 13.4 | >0 |  |
| tof_vl53l0x | `P-GEO-01:tof_vl53l0x` | valid single B-rep solid | ✅ | 1 | 1 |  |
| tof_vl53l0x | `P-GEO-02:tof_vl53l0x` | STEP round-trip volume error | ✅ | 0.0 | 0.001 | tof_vl53l0x.step |
| tof_vl53l0x | `V-DAT-01:tof_vl53l0x` | vendor data (mass, description, source) | ✅ | 1.0 | >0 |  |
| ubec_6v_10a | `P-GEO-01:ubec_6v_10a` | valid single B-rep solid | ✅ | 1 | 1 |  |
| ubec_6v_10a | `P-GEO-02:ubec_6v_10a` | STEP round-trip volume error | ✅ | 0.0 | 0.001 | ubec_6v_10a.step |
| ubec_6v_10a | `V-DAT-01:ubec_6v_10a` | vendor data (mass, description, source) | ✅ | 28.0 | >0 |  |
| xt60_panel_mount | `P-GEO-01:xt60_panel_mount` | valid single B-rep solid | ✅ | 1 | 1 |  |
| xt60_panel_mount | `P-GEO-02:xt60_panel_mount` | STEP round-trip volume error | ✅ | 0.0 | 0.001 | xt60_panel_mount.step |
| xt60_panel_mount | `V-DAT-01:xt60_panel_mount` | vendor data (mass, description, source) | ✅ | 6.0 | >0 |  |
| Kinematics, firmware & models | `S-KIN-01` | leg IK round-trip error (10 000 random poses) | ✅ | 0.0 | 1e-06 |  |
| Kinematics, firmware & models | `S-KIN-02` | analytic leg FK == CAD link-tree FK | ✅ | 0.0 | 1e-06 |  |
| Kinematics, firmware & models | `S-KIN-03` | arm IK round-trip error (6 000 poses, TCP + nozzle tools) | ✅ | 0.0 | 1e-06 | unsolved=0 |
| Kinematics, firmware & models | `S-KIN-04` | analytic arm FK == CAD link-tree FK (TCP and nozzle) | ✅ | 0.0 | 1e-06 |  |
| Kinematics, firmware & models | `S-FW-01` | firmware config.h matches params.py (regenerated) | ✅ | true | true |  |
| Kinematics, firmware & models | `S-FW-02` | full sketch compiles on host with -Wall -Wextra -Werror and runs 300 ticks | ✅ | 0 | 0 |  |
| Kinematics, firmware & models | `S-FW-03` | firmware (float32 C++) IK & crawl planner parity with Python | ✅ | {"max_angle_err_deg": 0.000509, "max_gait_err_mm": 9e-05} | {"max_angle_err_deg": 0.03, "max_gait_err_mm": 0.05} | 760 vectors (float32 vs float64) |
| Kinematics, firmware & models | `S-MOD-01` | MJCF compiles; mass == CAD mass (±0.5 %) | ✅ | 3193.7 | 3193.7 | nq=26 nu=17 nbody=22 |
| Kinematics, firmware & models | `S-MOD-02` | URDF forward kinematics == link tree (50 random poses) | ✅ | 0.0 | 0.001 | 17 actuated joints |
| BOM & documentation | `S-BOM-01` | every part instance appears in the BOM with the right quantity | ✅ | 0 | 0 | [] |
| BOM & documentation | `S-BOM-02` | every BOM part has its STEP (and STL for printed parts) | ✅ | 0 | 0 | [] |
| BOM & documentation | `S-BOM-03` | no orphan CAD files | ✅ | 0 | 0 | [] |
| BOM & documentation | `S-BOM-04` | BOM.md / BOM.csv generated | ✅ | true | true |  |
| BOM & documentation | `S-DOC-01` | all relative links in README/docs resolve | ✅ | 0 | 0 | [] |
| BOM & documentation | `S-DOC-02` | simulation videos present (5) | ✅ | 5 | 5 | 01_crawl_walk_turn.mp4, 02_watering_mission.mp4, 03_pick_and_place.mp4, 04_ik_showcase.mp4, 05_exploded_assembly.mp4 |
| Physics simulation (MuJoCo) | `S-SIM-01` | crawl speed with full tank | ✅ | 0.0272 | 0.02 |  |
| Physics simulation (MuJoCo) | `S-SIM-02` | body tilt during walk + turn | ✅ | 2.29 | 12.0 |  |
| Physics simulation (MuJoCo) | `S-SIM-03` | servo torque, 50 ms filtered peak (fraction of stall) | ✅ | 0.826 | 0.9 | joint FR_hip_pitch; raw peak 1.00 |
| Physics simulation (MuJoCo) | `S-SIM-04` | servo torque, 99th percentile (fraction of stall) | ✅ | 0.489 | 0.75 |  |
| Physics simulation (MuJoCo) | `S-SIM-05` | turn in place achieves ≥ 70 % of commanded yaw, no IK clamping | ✅ | 35.7 | 27.7 | IK clamps 0 |
| Physics simulation (MuJoCo) | `S-SIM-06` | watering: fraction of emitted water landing in target pots | ✅ | 1.0 | 0.85 | per plant [10.04, 10.04, 10.0] ml |
| Physics simulation (MuJoCo) | `S-SIM-07` | watering: mass balance exact, every plant dosed ≥ 90 %, no aim failures | ✅ | -0.0 | 0.01 | tank left 369.9 ml |
| Physics simulation (MuJoCo) | `S-SIM-08` | pick & place: lift ≥ 30 mm, placed ≤ 25 mm, no unreachable waypoints, no joint clamping | ✅ | {"lift_mm": 54.5, "place_err_mm": 1.2, "unreachable": 0, "ik_clamps": 0} | {"lift_mm": 30.0, "place_err_mm": 25.0} |  |
| Physics simulation (MuJoCo) | `S-SIM-09` | pick & place: servo 50 ms peak ≤ limit, tilt ≤ limit | ✅ | {"peak": 0.805, "tilt": 10.21} | {"peak": 0.9, "tilt": 12.0} |  |
| Physics simulation (MuJoCo) | `S-SIM-10` | IK showcase: arm Cartesian tracking error (analytic) | ✅ | 0.0 | 1e-05 |  |
| Physics simulation (MuJoCo) | `S-SIM-11` | gait robustness: cycle time ±10 % (walk & turn) upright, joint-limit contact ≤ 50 ms | ✅ | 5.2 | 12.0 | walk T=2.16s tilt 5.2° limit-contact 0 ms; walk T=2.64s tilt 1.3° limit-contact 0 ms; turn T=2.7s tilt 2.5° limit-contact 0 ms; turn T=3.3s tilt 3.7° limit-cont |
