jitendraphand/aquabot/sim/models/urdf/aquabot.urdf

<?xml version="1.0"?>
<!-- AquaBot v1.0.0 — generated by aquabot/urdf.py -->
<robot name="aquabot">
  <material name="gripper_pinion_mat"><color rgba="0.93 0.93 0.9 1"/></material>
  <material name="gripper_jaw_mat"><color rgba="0.93 0.93 0.9 1"/></material>
  <material name="nozzle_brass_mat"><color rgba="0.8 0.62 0.25 1"/></material>
  <material name="rod_3x74_mat"><color rgba="0.55 0.56 0.58 1"/></material>
  <material name="horn_mg90s_mat"><color rgba="0.75 0.76 0.78 1"/></material>
  <material name="gripper_base_mat"><color rgba="0.2 0.62 0.36 1"/></material>
  <material name="servo_mg90s_mat"><color rgba="0.08 0.08 0.09 1"/></material>
  <material name="forearm_mat"><color rgba="0.2 0.62 0.36 1"/></material>
  <material name="upper_arm_mat"><color rgba="0.2 0.62 0.36 1"/></material>
  <material name="arm_turntable_mat"><color rgba="0.2 0.62 0.36 1"/></material>
  <material name="tibia_R_mat"><color rgba="0.93 0.93 0.9 1"/></material>
  <material name="femur_R_mat"><color rgba="0.93 0.93 0.9 1"/></material>
  <material name="shoulder_bracket_R_mat"><color rgba="0.2 0.62 0.36 1"/></material>
  <material name="foot_pad_mat"><color rgba="0.1 0.1 0.1 1"/></material>
  <material name="tibia_L_mat"><color rgba="0.93 0.93 0.9 1"/></material>
  <material name="femur_L_mat"><color rgba="0.93 0.93 0.9 1"/></material>
  <material name="bearing_625_mat"><color rgba="0.55 0.56 0.58 1"/></material>
  <material name="horn_ds3218_mat"><color rgba="0.75 0.76 0.78 1"/></material>
  <material name="shoulder_bracket_L_mat"><color rgba="0.2 0.62 0.36 1"/></material>
  <material name="mosfet_module_mat"><color rgba="0.05 0.4 0.18 1"/></material>
  <material name="esp32_devkitc_mat"><color rgba="0.08 0.08 0.1 1"/></material>
  <material name="pca9685_mat"><color rgba="0.05 0.2 0.55 1"/></material>
  <material name="xt60_panel_mount_mat"><color rgba="0.9 0.8 0.1 1"/></material>
  <material name="rocker_switch_mat"><color rgba="0.08 0.08 0.09 1"/></material>
  <material name="tof_vl53l0x_mat"><color rgba="0.05 0.2 0.55 1"/></material>
  <material name="imu_mpu6050_mat"><color rgba="0.05 0.2 0.55 1"/></material>
  <material name="buck_5v_mat"><color rgba="0.05 0.2 0.55 1"/></material>
  <material name="ubec_6v_10a_mat"><color rgba="0.15 0.15 0.15 1"/></material>
  <material name="pump_peristaltic_mat"><color rgba="0.85 0.85 0.88 1"/></material>
  <material name="battery_2s_2200_mat"><color rgba="0.85 0.65 0.1 1"/></material>
  <material name="bearing_61806_mat"><color rgba="0.55 0.56 0.58 1"/></material>
  <material name="servo_ds3218_mat"><color rgba="0.08 0.08 0.09 1"/></material>
  <material name="arm_bearing_plate_mat"><color rgba="0.2 0.62 0.36 1"/></material>
  <material name="arm_pedestal_mat"><color rgba="0.2 0.62 0.36 1"/></material>
  <material name="electronics_cover_mat"><color rgba="0.2 0.62 0.36 1"/></material>
  <material name="electronics_tray_mat"><color rgba="0.93 0.93 0.9 1"/></material>
  <material name="fill_cap_mat"><color rgba="0.12 0.45 0.8 1"/></material>
  <material name="tank_lid_mat"><color rgba="0.12 0.45 0.8 1"/></material>
  <material name="tank_body_mat"><color rgba="0.12 0.45 0.8 1"/></material>
  <material name="top_deck_mat"><color rgba="0.93 0.93 0.9 1"/></material>
  <material name="bulkhead_rear_mat"><color rgba="0.93 0.93 0.9 1"/></material>
  <material name="bulkhead_front_mat"><color rgba="0.93 0.93 0.9 1"/></material>
  <material name="chassis_tub_mat"><color rgba="0.93 0.93 0.9 1"/></material>
  <link name="base">
    <inertial><origin xyz="0.005716590713 -0.0005681515284 0.009157150311" rpy="0 0 0"/><mass value="1.456936"/>
      <inertia ixx="2.5915e-03" ixy="4.6573e-05" ixz="-3.3150e-04" iyy="5.8629e-03" iyz="4.2190e-05" izz="5.4276e-03"/></inertial>
    <visual name="chassis_tub"><origin xyz="0 0 0" rpy="0 -0 0"/><geometry><mesh filename="package://aquabot_description/meshes/chassis_tub.stl" scale="0.001 0.001 0.001"/></geometry><material name="chassis_tub_mat"/></visual>
    <visual name="bulkhead_front"><origin xyz="0 0 0" rpy="0 -0 0"/><geometry><mesh filename="package://aquabot_description/meshes/bulkhead_front.stl" scale="0.001 0.001 0.001"/></geometry><material name="bulkhead_front_mat"/></visual>
    <visual name="bulkhead_rear"><origin xyz="0 0 0" rpy="0 -0 3.141592654"/><geometry><mesh filename="package://aquabot_description/meshes/bulkhead_rear.stl" scale="0.001 0.001 0.001"/></geometry><material name="bulkhead_rear_mat"/></visual>
    <visual name="top_deck"><origin xyz="0 0 0" rpy="0 -0 0"/><geometry><mesh filename="package://aquabot_description/meshes/top_deck.stl" scale="0.001 0.001 0.001"/></geometry><material name="top_deck_mat"/></visual>
    <visual name="tank_body"><origin xyz="0 0 0" rpy="0 -0 0"/><geometry><mesh filename="package://aquabot_description/meshes/tank_body.stl" scale="0.001 0.001 0.001"/></geometry><material name="tank_body_mat"/></visual>
    <visual name="tank_lid"><origin xyz="0 0 0" rpy="0 -0 0"/><geometry><mesh filename="package://aquabot_description/meshes/tank_lid.stl" scale="0.001 0.001 0.001"/></geometry><material name="tank_lid_mat"/></visual>
    <visual name="fill_cap"><origin xyz="0 0 0" rpy="0 -0 0"/><geometry><mesh filename="package://aquabot_description/meshes/fill_cap.stl" scale="0.001 0.001 0.001"/></geometry><material name="fill_cap_mat"/></visual>
    <visual name="electronics_tray"><origin xyz="0 0 0" rpy="0 -0 0"/><geometry><mesh filename="package://aquabot_description/meshes/electronics_tray.stl" scale="0.001 0.001 0.001"/></geometry><material name="electronics_tray_mat"/></visual>
    <visual name="electronics_cover"><origin xyz="0 0 0" rpy="0 -0 0"/><geometry><mesh filename="package://aquabot_description/meshes/electronics_cover.stl" scale="0.001 0.001 0.001"/></geometry><material name="electronics_cover_mat"/></visual>
    <visual name="arm_pedestal"><origin xyz="0 0 0" rpy="0 -0 0"/><geometry><mesh filename="package://aquabot_description/meshes/arm_pedestal.stl" scale="0.001 0.001 0.001"/></geometry><material name="arm_pedestal_mat"/></visual>
    <visual name="arm_bearing_plate"><origin xyz="0 0 0" rpy="0 -0 0"/><geometry><mesh filename="package://aquabot_description/meshes/arm_bearing_plate.stl" scale="0.001 0.001 0.001"/></geometry><material name="arm_bearing_plate_mat"/></visual>
    <visual name="servo_FL_J1"><origin xyz="0.1085 0.028 0" rpy="-0 1.570796327 0"/><geometry><mesh filename="package://aquabot_description/meshes/servo_ds3218.stl" scale="0.001 0.001 0.001"/></geometry><material name="servo_ds3218_mat"/></visual>
    <visual name="servo_FR_J1"><origin xyz="0.1085 -0.028 0" rpy="-0 1.570796327 0"/><geometry><mesh filename="package://aquabot_description/meshes/servo_ds3218.stl" scale="0.001 0.001 0.001"/></geometry><material name="servo_ds3218_mat"/></visual>
    <visual name="servo_RL_J1"><origin xyz="-0.1085 0.028 0" rpy="-3.141592654 1.570796327 0"/><geometry><mesh filename="package://aquabot_description/meshes/servo_ds3218.stl" scale="0.001 0.001 0.001"/></geometry><material name="servo_ds3218_mat"/></visual>
    <visual name="servo_RR_J1"><origin xyz="-0.1085 -0.028 0" rpy="-3.141592654 1.570796327 0"/><geometry><mesh filename="package://aquabot_description/meshes/servo_ds3218.stl" scale="0.001 0.001 0.001"/></geometry><material name="servo_ds3218_mat"/></visual>
    <visual name="servo_arm_yaw"><origin xyz="0.055 0 0.082" rpy="0 -0 -1.570796327"/><geometry><mesh filename="package://aquabot_description/meshes/servo_ds3218.stl" scale="0.001 0.001 0.001"/></geometry><material name="servo_ds3218_mat"/></visual>
    <visual name="bearing_yaw"><origin xyz="0.055 0 0.087" rpy="0 -0 0"/><geometry><mesh filename="package://aquabot_description/meshes/bearing_61806.stl" scale="0.001 0.001 0.001"/></geometry><material name="bearing_61806_mat"/></visual>
    <visual name="battery"><origin xyz="-0.018 0 0.0045" rpy="0 -0 0"/><geometry><mesh filename="package://aquabot_description/meshes/battery_2s_2200.stl" scale="0.001 0.001 0.001"/></geometry><material name="battery_2s_2200_mat"/></visual>
    <visual name="pump"><origin xyz="-0.064 -0.014 0.0029" rpy="0 -0 0"/><geometry><mesh filename="package://aquabot_description/meshes/pump_peristaltic.stl" scale="0.001 0.001 0.001"/></geometry><material name="pump_peristaltic_mat"/></visual>
    <visual name="ubec_L"><origin xyz="0.02 0.019 0.0029" rpy="0 -0 0"/><geometry><mesh filename="package://aquabot_description/meshes/ubec_6v_10a.stl" scale="0.001 0.001 0.001"/></geometry><material name="ubec_6v_10a_mat"/></visual>
    <visual name="ubec_R"><origin xyz="0.02 -0.0425 0.0029" rpy="0 -0 0"/><geometry><mesh filename="package://aquabot_description/meshes/ubec_6v_10a.stl" scale="0.001 0.001 0.001"/></geometry><material name="ubec_6v_10a_mat"/></visual>
    <visual name="buck_5v"><origin xyz="0.002 0.022 0.0029" rpy="0 -0 0"/><geometry><mesh filename="package://aquabot_description/meshes/buck_5v.stl" scale="0.001 0.001 0.001"/></geometry><material name="buck_5v_mat"/></visual>
    <visual name="imu"><origin xyz="-0.026 0.022 0.0029" rpy="0 -0 0"/><geometry><mesh filename="package://aquabot_description/meshes/imu_mpu6050.stl" scale="0.001 0.001 0.001"/></geometry><material name="imu_mpu6050_mat"/></visual>
    <visual name="tof"><origin xyz="0.086 -0.0125 -0.019" rpy="1.570796327 -0 1.570796327"/><geometry><mesh filename="package://aquabot_description/meshes/tof_vl53l0x.stl" scale="0.001 0.001 0.001"/></geometry><material name="tof_vl53l0x_mat"/></visual>
    <visual name="rocker_switch"><origin xyz="-0.095 0 -0.0125" rpy="0 -0 3.141592654"/><geometry><mesh filename="package://aquabot_description/meshes/rocker_switch.stl" scale="0.001 0.001 0.001"/></geometry><material name="rocker_switch_mat"/></visual>
    <visual name="xt60_port"><origin xyz="-0.095 0 0.024" rpy="0 -0 3.141592654"/><geometry><mesh filename="package://aquabot_description/meshes/xt60_panel_mount.stl" scale="0.001 0.001 0.001"/></geometry><material name="xt60_panel_mount_mat"/></visual>
    <visual name="pca9685"><origin xyz="-0.0295 -0.036 0.046" rpy="0 -0 0"/><geometry><mesh filename="package://aquabot_description/meshes/pca9685.stl" scale="0.001 0.001 0.001"/></geometry><material name="pca9685_mat"/></visual>
    <visual name="esp32"><origin xyz="-0.024 0.007 0.048" rpy="0 -0 0"/><geometry><mesh filename="package://aquabot_description/meshes/esp32_devkitc.stl" scale="0.001 0.001 0.001"/></geometry><material name="esp32_devkitc_mat"/></visual>
    <visual name="mosfet"><origin xyz="0 -0.0102 0.043" rpy="0 -0 0"/><geometry><mesh filename="package://aquabot_description/meshes/mosfet_module.stl" scale="0.001 0.001 0.001"/></geometry><material name="mosfet_module_mat"/></visual>
    <collision><origin xyz="0 0 -0.005"/><geometry><box size="0.19 0.092 0.09"/></geometry></collision>
  </link>
  <link name="FL_hip">
    <inertial><origin xyz="0.01833686973 0.0196834323 -0.02512247784" rpy="0 0 0"/><mass value="0.097766"/>
      <inertia ixx="6.5586e-05" ixy="-3.9145e-06" ixz="6.0114e-06" iyy="4.9228e-05" iyz="9.4643e-06" izz="3.2085e-05"/></inertial>
    <visual name="shoulder_bracket_FL"><origin xyz="0 0 0" rpy="0 -0 0"/><geometry><mesh filename="package://aquabot_description/meshes/shoulder_bracket_L.stl" scale="0.001 0.001 0.001"/></geometry><material name="shoulder_bracket_L_mat"/></visual>
    <visual name="servo_FL_J2"><origin xyz="0.021 0.04725 -0.045" rpy="-1.570796327 -1.570796327 0"/><geometry><mesh filename="package://aquabot_description/meshes/servo_ds3218.stl" scale="0.001 0.001 0.001"/></geometry><material name="servo_ds3218_mat"/></visual>
    <visual name="horn_FL_J1"><origin xyz="-0.0075 0 0" rpy="-0 1.570796327 0"/><geometry><mesh filename="package://aquabot_description/meshes/horn_ds3218.stl" scale="0.001 0.001 0.001"/></geometry><material name="horn_ds3218_mat"/></visual>
    <visual name="bearing_FL_J2"><origin xyz="0.021 -0.00675 -0.045" rpy="-1.570796327 -0 0"/><geometry><mesh filename="package://aquabot_description/meshes/bearing_625.stl" scale="0.001 0.001 0.001"/></geometry><material name="bearing_625_mat"/></visual>
  </link>
  <joint name="FL_hip_abd" type="revolute">
    <parent link="base"/><child link="FL_hip"/>
    <origin xyz="0.116 0.028 0" rpy="0 -0 0"/><axis xyz="1 0 0"/>
    <limit lower="-0.20944" upper="0.43633" effort="1.960" velocity="7.00"/>
  </joint>
  <link name="FL_femur">
    <inertial><origin xyz="-0.0002032541448 -0.004480993428 -0.06616299959" rpy="0 0 0"/><mass value="0.119243"/>
      <inertia ixx="1.3974e-04" ixy="-6.3811e-07" ixz="-1.9852e-08" iyy="1.1171e-04" iyz="-1.7283e-05" izz="4.0554e-05"/></inertial>
    <visual name="femur_FL"><origin xyz="0 0 0" rpy="0 -0 0"/><geometry><mesh filename="package://aquabot_description/meshes/femur_L.stl" scale="0.001 0.001 0.001"/></geometry><material name="femur_L_mat"/></visual>
    <visual name="servo_FL_J3"><origin xyz="0 0.01725 -0.09" rpy="-1.570796327 -1.570796327 0"/><geometry><mesh filename="package://aquabot_description/meshes/servo_ds3218.stl" scale="0.001 0.001 0.001"/></geometry><material name="servo_ds3218_mat"/></visual>
    <visual name="horn_FL_J2"><origin xyz="0 0.01725 0" rpy="-1.570796327 -1.570796327 0"/><geometry><mesh filename="package://aquabot_description/meshes/horn_ds3218.stl" scale="0.001 0.001 0.001"/></geometry><material name="horn_ds3218_mat"/></visual>
    <visual name="bearing_FL_J3"><origin xyz="0 -0.03675 -0.09" rpy="-1.570796327 -0 0"/><geometry><mesh filename="package://aquabot_description/meshes/bearing_625.stl" scale="0.001 0.001 0.001"/></geometry><material name="bearing_625_mat"/></visual>
  </link>
  <joint name="FL_hip_pitch" type="revolute">
    <parent link="FL_hip"/><child link="FL_femur"/>
    <origin xyz="0.021 0.03 -0.045" rpy="0 -0 0"/><axis xyz="0 1 0"/>
    <limit lower="-1.30900" upper="1.04720" effort="1.960" velocity="7.00"/>
  </joint>
  <link name="FL_tibia">
    <inertial><origin xyz="1.73125168e-10 0.003937095831 -0.03759786093" rpy="0 0 0"/><mass value="0.034486"/>
      <inertia ixx="5.3884e-05" ixy="1.7048e-14" ixz="2.3815e-13" iyy="4.4081e-05" iyz="-5.1049e-06" izz="1.2647e-05"/></inertial>
    <visual name="tibia_FL"><origin xyz="0 0 0" rpy="0 -0 0"/><geometry><mesh filename="package://aquabot_description/meshes/tibia_L.stl" scale="0.001 0.001 0.001"/></geometry><material name="tibia_L_mat"/></visual>
    <visual name="foot_FL"><origin xyz="0 0 0" rpy="0 -0 0"/><geometry><mesh filename="package://aquabot_description/meshes/foot_pad.stl" scale="0.001 0.001 0.001"/></geometry><material name="foot_pad_mat"/></visual>
    <visual name="horn_FL_J3"><origin xyz="0 0.01725 0" rpy="-1.570796327 -1.570796327 0"/><geometry><mesh filename="package://aquabot_description/meshes/horn_ds3218.stl" scale="0.001 0.001 0.001"/></geometry><material name="horn_ds3218_mat"/></visual>
    <collision><origin xyz="0 0 -0.1000"/><geometry><sphere radius="0.0130"/></geometry></collision>
  </link>
  <joint name="FL_knee" type="revolute">
    <parent link="FL_femur"/><child link="FL_tibia"/>
    <origin xyz="0 0 -0.09" rpy="0 -0 0"/><axis xyz="0 1 0"/>
    <limit lower="-2.18166" upper="-0.17453" effort="1.960" velocity="7.00"/>
  </joint>
  <link name="FR_hip">
    <inertial><origin xyz="0.01833686973 -0.0196834323 -0.02512247784" rpy="0 0 0"/><mass value="0.097766"/>
      <inertia ixx="6.5586e-05" ixy="3.9145e-06" ixz="6.0114e-06" iyy="4.9228e-05" iyz="-9.4643e-06" izz="3.2085e-05"/></inertial>
    <visual name="shoulder_bracket_FR"><origin xyz="0 0 0" rpy="0 -0 0"/><geometry><mesh filename="package://aquabot_description/meshes/shoulder_bracket_R.stl" scale="0.001 0.001 0.001"/></geometry><material name="shoulder_bracket_R_mat"/></visual>
    <visual name="servo_FR_J2"><origin xyz="0.021 -0.04725 -0.045" rpy="1.570796327 -1.570796327 0"/><geometry><mesh filename="package://aquabot_description/meshes/servo_ds3218.stl" scale="0.001 0.001 0.001"/></geometry><material name="servo_ds3218_mat"/></visual>
    <visual name="horn_FR_J1"><origin xyz="-0.0075 0 0" rpy="-0 1.570796327 0"/><geometry><mesh filename="package://aquabot_description/meshes/horn_ds3218.stl" scale="0.001 0.001 0.001"/></geometry><material name="horn_ds3218_mat"/></visual>
    <visual name="bearing_FR_J2"><origin xyz="0.021 0.00675 -0.045" rpy="1.570796327 -0 0"/><geometry><mesh filename="package://aquabot_description/meshes/bearing_625.stl" scale="0.001 0.001 0.001"/></geometry><material name="bearing_625_mat"/></visual>
  </link>
  <joint name="FR_hip_abd" type="revolute">
    <parent link="base"/><child link="FR_hip"/>
    <origin xyz="0.116 -0.028 0" rpy="0 -0 0"/><axis xyz="1 0 0"/>
    <limit lower="-0.43633" upper="0.20944" effort="1.960" velocity="7.00"/>
  </joint>
  <link name="FR_femur">
    <inertial><origin xyz="-0.0002032541448 0.004480993428 -0.06616299959" rpy="0 0 0"/><mass value="0.119243"/>
      <inertia ixx="1.3974e-04" ixy="6.3811e-07" ixz="-1.9852e-08" iyy="1.1171e-04" iyz="1.7283e-05" izz="4.0554e-05"/></inertial>
    <visual name="femur_FR"><origin xyz="0 0 0" rpy="0 -0 0"/><geometry><mesh filename="package://aquabot_description/meshes/femur_R.stl" scale="0.001 0.001 0.001"/></geometry><material name="femur_R_mat"/></visual>
    <visual name="servo_FR_J3"><origin xyz="0 -0.01725 -0.09" rpy="1.570796327 -1.570796327 0"/><geometry><mesh filename="package://aquabot_description/meshes/servo_ds3218.stl" scale="0.001 0.001 0.001"/></geometry><material name="servo_ds3218_mat"/></visual>
    <visual name="horn_FR_J2"><origin xyz="0 -0.01725 0" rpy="1.570796327 -1.570796327 0"/><geometry><mesh filename="package://aquabot_description/meshes/horn_ds3218.stl" scale="0.001 0.001 0.001"/></geometry><material name="horn_ds3218_mat"/></visual>
    <visual name="bearing_FR_J3"><origin xyz="0 0.03675 -0.09" rpy="1.570796327 -0 0"/><geometry><mesh filename="package://aquabot_description/meshes/bearing_625.stl" scale="0.001 0.001 0.001"/></geometry><material name="bearing_625_mat"/></visual>
  </link>
  <joint name="FR_hip_pitch" type="revolute">
    <parent link="FR_hip"/><child link="FR_femur"/>
    <origin xyz="0.021 -0.03 -0.045" rpy="0 -0 0"/><axis xyz="0 1 0"/>
    <limit lower="-1.30900" upper="1.04720" effort="1.960" velocity="7.00"/>
  </joint>
  <link name="FR_tibia">
    <inertial><origin xyz="1.731251679e-10 -0.003937095891 -0.03759786093" rpy="0 0 0"/><mass value="0.034486"/>
      <inertia ixx="5.3884e-05" ixy="-1.7770e-14" ixz="2.3815e-13" iyy="4.4081e-05" iyz="5.1049e-06" izz="1.2647e-05"/></inertial>
    <visual name="tibia_FR"><origin xyz="0 0 0" rpy="0 -0 0"/><geometry><mesh filename="package://aquabot_description/meshes/tibia_R.stl" scale="0.001 0.001 0.001"/></geometry><material name="tibia_R_mat"/></visual>
    <visual name="foot_FR"><origin xyz="0 0 0" rpy="0 -0 0"/><geometry><mesh filename="package://aquabot_description/meshes/foot_pad.stl" scale="0.001 0.001 0.001"/></geometry><material name="foot_pad_mat"/></visual>
    <visual name="horn_FR_J3"><origin xyz="0 -0.01725 0" rpy="1.570796327 -1.570796327 0"/><geometry><mesh filename="package://aquabot_description/meshes/horn_ds3218.stl" scale="0.001 0.001 0.001"/></geometry><material name="horn_ds3218_mat"/></visual>
    <collision><origin xyz="0 0 -0.1000"/><geometry><sphere radius="0.0130"/></geometry></collision>
  </link>
  <joint name="FR_knee" type="revolute">
    <parent link="FR_femur"/><child link="FR_tibia"/>
    <origin xyz="0 0 -0.09" rpy="0 -0 0"/><axis xyz="0 1 0"/>
    <limit lower="-2.18166" upper="-0.17453" effort="1.960" velocity="7.00"/>
  </joint>
  <link name="RL_hip">
    <inertial><origin xyz="-0.01833686973 0.0196834323 -0.02512247784" rpy="0 0 0"/><mass value="0.097766"/>
      <inertia ixx="6.5586e-05" ixy="3.9145e-06" ixz="-6.0114e-06" iyy="4.9228e-05" iyz="9.4643e-06" izz="3.2085e-05"/></inertial>
    <visual name="shoulder_bracket_RL"><origin xyz="0 0 0" rpy="0 -0 3.141592654"/><geometry><mesh filename="package://aquabot_description/meshes/shoulder_bracket_R.stl" scale="0.001 0.001 0.001"/></geometry><material name="shoulder_bracket_R_mat"/></visual>
    <visual name="servo_RL_J2"><origin xyz="-0.021 0.04725 -0.045" rpy="-1.570796327 -1.570796327 0"/><geometry><mesh filename="package://aquabot_description/meshes/servo_ds3218.stl" scale="0.001 0.001 0.001"/></geometry><material name="servo_ds3218_mat"/></visual>
    <visual name="horn_RL_J1"><origin xyz="0.0075 -9.184850994e-19 0" rpy="-3.141592654 1.570796327 0"/><geometry><mesh filename="package://aquabot_description/meshes/horn_ds3218.stl" scale="0.001 0.001 0.001"/></geometry><material name="horn_ds3218_mat"/></visual>
    <visual name="bearing_RL_J2"><origin xyz="-0.021 -0.00675 -0.045" rpy="1.570796327 -0 3.141592654"/><geometry><mesh filename="package://aquabot_description/meshes/bearing_625.stl" scale="0.001 0.001 0.001"/></geometry><material name="bearing_625_mat"/></visual>
  </link>
  <joint name="RL_hip_abd" type="revolute">
    <parent link="base"/><child link="RL_hip"/>
    <origin xyz="-0.116 0.028 0" rpy="0 -0 0"/><axis xyz="1 0 0"/>
    <limit lower="-0.20944" upper="0.43633" effort="1.960" velocity="7.00"/>
  </joint>
  <link name="RL_femur">
    <inertial><origin xyz="0.0002032541448 -0.004480993428 -0.06616299959" rpy="0 0 0"/><mass value="0.119243"/>
      <inertia ixx="1.3974e-04" ixy="6.3811e-07" ixz="1.9852e-08" iyy="1.1171e-04" iyz="-1.7283e-05" izz="4.0554e-05"/></inertial>
    <visual name="femur_RL"><origin xyz="0 0 0" rpy="0 -0 3.141592654"/><geometry><mesh filename="package://aquabot_description/meshes/femur_R.stl" scale="0.001 0.001 0.001"/></geometry><material name="femur_R_mat"/></visual>
    <visual name="servo_RL_J3"><origin xyz="0 0.01725 -0.09" rpy="-1.570796327 -1.570796327 0"/><geometry><mesh filename="package://aquabot_description/meshes/servo_ds3218.stl" scale="0.001 0.001 0.001"/></geometry><material name="servo_ds3218_mat"/></visual>
    <visual name="horn_RL_J2"><origin xyz="0 0.01725 0" rpy="-1.570796327 -1.570796327 0"/><geometry><mesh filename="package://aquabot_description/meshes/horn_ds3218.stl" scale="0.001 0.001 0.001"/></geometry><material name="horn_ds3218_mat"/></visual>
    <visual name="bearing_RL_J3"><origin xyz="0 -0.03675 -0.09" rpy="-1.570796327 -0 0"/><geometry><mesh filename="package://aquabot_description/meshes/bearing_625.stl" scale="0.001 0.001 0.001"/></geometry><material name="bearing_625_mat"/></visual>
  </link>
  <joint name="RL_hip_pitch" type="revolute">
    <parent link="RL_hip"/><child link="RL_femur"/>
    <origin xyz="-0.021 0.03 -0.045" rpy="0 -0 0"/><axis xyz="0 1 0"/>
    <limit lower="-1.04720" upper="1.30900" effort="1.960" velocity="7.00"/>
  </joint>
  <link name="RL_tibia">
    <inertial><origin xyz="-3.214531582e-10 0.003937095831 -0.03759786093" rpy="0 0 0"/><mass value="0.034486"/>
      <inertia ixx="5.3884e-05" ixy="-3.7910e-14" ixz="-5.3962e-13" iyy="4.4081e-05" iyz="-5.1049e-06" izz="1.2647e-05"/></inertial>
    <visual name="tibia_RL"><origin xyz="0 0 0" rpy="0 -0 3.141592654"/><geometry><mesh filename="package://aquabot_description/meshes/tibia_R.stl" scale="0.001 0.001 0.001"/></geometry><material name="tibia_R_mat"/></visual>
    <visual name="foot_RL"><origin xyz="0 0 0" rpy="0 -0 0"/><geometry><mesh filename="package://aquabot_description/meshes/foot_pad.stl" scale="0.001 0.001 0.001"/></geometry><material name="foot_pad_mat"/></visual>
    <visual name="horn_RL_J3"><origin xyz="0 0.01725 0" rpy="-1.570796327 -1.570796327 0"/><geometry><mesh filename="package://aquabot_description/meshes/horn_ds3218.stl" scale="0.001 0.001 0.001"/></geometry><material name="horn_ds3218_mat"/></visual>
    <collision><origin xyz="0 0 -0.1000"/><geometry><sphere radius="0.0130"/></geometry></collision>
  </link>
  <joint name="RL_knee" type="revolute">
    <parent link="RL_femur"/><child link="RL_tibia"/>
    <origin xyz="0 0 -0.09" rpy="0 -0 0"/><axis xyz="0 1 0"/>
    <limit lower="0.17453" upper="2.18166" effort="1.960" velocity="7.00"/>
  </joint>
  <link name="RR_hip">
    <inertial><origin xyz="-0.01833686973 -0.0196834323 -0.02512247784" rpy="0 0 0"/><mass value="0.097766"/>
      <inertia ixx="6.5586e-05" ixy="-3.9145e-06" ixz="-6.0114e-06" iyy="4.9228e-05" iyz="-9.4643e-06" izz="3.2085e-05"/></inertial>
    <visual name="shoulder_bracket_RR"><origin xyz="0 0 0" rpy="0 -0 3.141592654"/><geometry><mesh filename="package://aquabot_description/meshes/shoulder_bracket_L.stl" scale="0.001 0.001 0.001"/></geometry><material name="shoulder_bracket_L_mat"/></visual>
    <visual name="servo_RR_J2"><origin xyz="-0.021 -0.04725 -0.045" rpy="1.570796327 -1.570796327 0"/><geometry><mesh filename="package://aquabot_description/meshes/servo_ds3218.stl" scale="0.001 0.001 0.001"/></geometry><material name="servo_ds3218_mat"/></visual>
    <visual name="horn_RR_J1"><origin xyz="0.0075 -9.184850994e-19 0" rpy="-3.141592654 1.570796327 0"/><geometry><mesh filename="package://aquabot_description/meshes/horn_ds3218.stl" scale="0.001 0.001 0.001"/></geometry><material name="horn_ds3218_mat"/></visual>
    <visual name="bearing_RR_J2"><origin xyz="-0.021 0.00675 -0.045" rpy="-1.570796327 -0 3.141592654"/><geometry><mesh filename="package://aquabot_description/meshes/bearing_625.stl" scale="0.001 0.001 0.001"/></geometry><material name="bearing_625_mat"/></visual>
  </link>
  <joint name="RR_hip_abd" type="revolute">
    <parent link="base"/><child link="RR_hip"/>
    <origin xyz="-0.116 -0.028 0" rpy="0 -0 0"/><axis xyz="1 0 0"/>
    <limit lower="-0.43633" upper="0.20944" effort="1.960" velocity="7.00"/>
  </joint>
  <link name="RR_femur">
    <inertial><origin xyz="0.0002032541448 0.004480993428 -0.06616299959" rpy="0 0 0"/><mass value="0.119243"/>
      <inertia ixx="1.3974e-04" ixy="-6.3811e-07" ixz="1.9852e-08" iyy="1.1171e-04" iyz="1.7283e-05" izz="4.0554e-05"/></inertial>
    <visual name="femur_RR"><origin xyz="0 0 0" rpy="0 -0 3.141592654"/><geometry><mesh filename="package://aquabot_description/meshes/femur_L.stl" scale="0.001 0.001 0.001"/></geometry><material name="femur_L_mat"/></visual>
    <visual name="servo_RR_J3"><origin xyz="0 -0.01725 -0.09" rpy="1.570796327 -1.570796327 0"/><geometry><mesh filename="package://aquabot_description/meshes/servo_ds3218.stl" scale="0.001 0.001 0.001"/></geometry><material name="servo_ds3218_mat"/></visual>
    <visual name="horn_RR_J2"><origin xyz="0 -0.01725 0" rpy="1.570796327 -1.570796327 0"/><geometry><mesh filename="package://aquabot_description/meshes/horn_ds3218.stl" scale="0.001 0.001 0.001"/></geometry><material name="horn_ds3218_mat"/></visual>
    <visual name="bearing_RR_J3"><origin xyz="0 0.03675 -0.09" rpy="1.570796327 -0 0"/><geometry><mesh filename="package://aquabot_description/meshes/bearing_625.stl" scale="0.001 0.001 0.001"/></geometry><material name="bearing_625_mat"/></visual>
  </link>
  <joint name="RR_hip_pitch" type="revolute">
    <parent link="RR_hip"/><child link="RR_femur"/>
    <origin xyz="-0.021 -0.03 -0.045" rpy="0 -0 0"/><axis xyz="0 1 0"/>
    <limit lower="-1.04720" upper="1.30900" effort="1.960" velocity="7.00"/>
  </joint>
  <link name="RR_tibia">
    <inertial><origin xyz="-3.214531584e-10 -0.003937095891 -0.03759786093" rpy="0 0 0"/><mass value="0.034486"/>
      <inertia ixx="5.3884e-05" ixy="3.7188e-14" ixz="-5.3962e-13" iyy="4.4081e-05" iyz="5.1049e-06" izz="1.2647e-05"/></inertial>
    <visual name="tibia_RR"><origin xyz="0 0 0" rpy="0 -0 3.141592654"/><geometry><mesh filename="package://aquabot_description/meshes/tibia_L.stl" scale="0.001 0.001 0.001"/></geometry><material name="tibia_L_mat"/></visual>
    <visual name="foot_RR"><origin xyz="0 0 0" rpy="0 -0 0"/><geometry><mesh filename="package://aquabot_description/meshes/foot_pad.stl" scale="0.001 0.001 0.001"/></geometry><material name="foot_pad_mat"/></visual>
    <visual name="horn_RR_J3"><origin xyz="0 -0.01725 0" rpy="1.570796327 -1.570796327 0"/><geometry><mesh filename="package://aquabot_description/meshes/horn_ds3218.stl" scale="0.001 0.001 0.001"/></geometry><material name="horn_ds3218_mat"/></visual>
    <collision><origin xyz="0 0 -0.1000"/><geometry><sphere radius="0.0130"/></geometry></collision>
  </link>
  <joint name="RR_knee" type="revolute">
    <parent link="RR_femur"/><child link="RR_tibia"/>
    <origin xyz="0 0 -0.09" rpy="0 -0 0"/><axis xyz="0 1 0"/>
    <limit lower="0.17453" upper="2.18166" effort="1.960" velocity="7.00"/>
  </joint>
  <link name="arm_turntable">
    <inertial><origin xyz="-0.007361579236 0.005032507592 0.02958828852" rpy="0 0 0"/><mass value="0.095129"/>
      <inertia ixx="4.5037e-05" ixy="-1.9216e-06" ixz="4.2747e-06" iyy="3.9785e-05" iyz="-1.9854e-06" izz="3.7352e-05"/></inertial>
    <visual name="arm_turntable"><origin xyz="0 0 0" rpy="0 -0 0"/><geometry><mesh filename="package://aquabot_description/meshes/arm_turntable.stl" scale="0.001 0.001 0.001"/></geometry><material name="arm_turntable_mat"/></visual>
    <visual name="horn_arm_yaw"><origin xyz="0 0 -0.0075" rpy="0 -0 -1.570796327"/><geometry><mesh filename="package://aquabot_description/meshes/horn_ds3218.stl" scale="0.001 0.001 0.001"/></geometry><material name="horn_ds3218_mat"/></visual>
    <visual name="servo_arm_shoulder"><origin xyz="0 -0.01725 0.0385" rpy="-1.570796327 -0 3.141592654"/><geometry><mesh filename="package://aquabot_description/meshes/servo_ds3218.stl" scale="0.001 0.001 0.001"/></geometry><material name="servo_ds3218_mat"/></visual>
    <visual name="bearing_arm_shoulder"><origin xyz="0 0.03175 0.0385" rpy="-1.570796327 -0 0"/><geometry><mesh filename="package://aquabot_description/meshes/bearing_625.stl" scale="0.001 0.001 0.001"/></geometry><material name="bearing_625_mat"/></visual>
  </link>
  <joint name="arm_yaw" type="revolute">
    <parent link="base"/><child link="arm_turntable"/>
    <origin xyz="0.055 0 0.0895" rpy="0 -0 0"/><axis xyz="0 0 1"/>
    <limit lower="-2.09440" upper="2.09440" effort="1.960" velocity="7.00"/>
  </joint>
  <link name="arm_upper">
    <inertial><origin xyz="-0.0001911650349 -0.004424774517 -0.08791482063" rpy="0 0 0"/><mass value="0.127449"/>
      <inertia ixx="2.4046e-04" ixy="-6.4283e-07" ixz="-2.2091e-07" iyy="2.1203e-04" iyz="-2.4655e-05" izz="4.2362e-05"/></inertial>
    <visual name="upper_arm"><origin xyz="0 0 0" rpy="0 -0 0"/><geometry><mesh filename="package://aquabot_description/meshes/upper_arm.stl" scale="0.001 0.001 0.001"/></geometry><material name="upper_arm_mat"/></visual>
    <visual name="servo_arm_elbow"><origin xyz="0 0.01725 -0.12" rpy="-1.570796327 -1.570796327 0"/><geometry><mesh filename="package://aquabot_description/meshes/servo_ds3218.stl" scale="0.001 0.001 0.001"/></geometry><material name="servo_ds3218_mat"/></visual>
    <visual name="horn_arm_shoulder"><origin xyz="0 0.01725 0" rpy="-1.570796327 -1.570796327 0"/><geometry><mesh filename="package://aquabot_description/meshes/horn_ds3218.stl" scale="0.001 0.001 0.001"/></geometry><material name="horn_ds3218_mat"/></visual>
    <visual name="bearing_arm_elbow"><origin xyz="0 -0.03675 -0.12" rpy="-1.570796327 -0 0"/><geometry><mesh filename="package://aquabot_description/meshes/bearing_625.stl" scale="0.001 0.001 0.001"/></geometry><material name="bearing_625_mat"/></visual>
  </link>
  <joint name="arm_shoulder" type="revolute">
    <parent link="arm_turntable"/><child link="arm_upper"/>
    <origin xyz="0 0 0.0385" rpy="-3.141592654 1.570796327 0"/><axis xyz="0 1 0"/>
    <limit lower="-0.47124" upper="2.18166" effort="1.960" velocity="7.00"/>
  </joint>
  <link name="arm_fore">
    <inertial><origin xyz="4.108476957e-19 0.005690703055 -0.05852539185" rpy="0 0 0"/><mass value="0.050627"/>
      <inertia ixx="1.1635e-04" ixy="5.0689e-22" ixz="-1.2635e-22" iyy="1.0558e-04" iyz="-2.2280e-06" izz="1.4675e-05"/></inertial>
    <visual name="forearm"><origin xyz="0 0 0" rpy="0 -0 0"/><geometry><mesh filename="package://aquabot_description/meshes/forearm.stl" scale="0.001 0.001 0.001"/></geometry><material name="forearm_mat"/></visual>
    <visual name="servo_arm_wrist"><origin xyz="0 0.01675 -0.115" rpy="-1.570796327 -1.570796327 0"/><geometry><mesh filename="package://aquabot_description/meshes/servo_mg90s.stl" scale="0.001 0.001 0.001"/></geometry><material name="servo_mg90s_mat"/></visual>
    <visual name="horn_arm_elbow"><origin xyz="0 0.01725 0" rpy="-1.570796327 -1.570796327 0"/><geometry><mesh filename="package://aquabot_description/meshes/horn_ds3218.stl" scale="0.001 0.001 0.001"/></geometry><material name="horn_ds3218_mat"/></visual>
  </link>
  <joint name="arm_elbow" type="revolute">
    <parent link="arm_upper"/><child link="arm_fore"/>
    <origin xyz="0 0 -0.12" rpy="0 -0 0"/><axis xyz="0 1 0"/>
    <limit lower="-2.18166" upper="0.26180" effort="1.960" velocity="7.00"/>
  </joint>
  <link name="arm_wrist">
    <inertial><origin xyz="-0.002249021705 0.003883358686 -0.04330376636" rpy="0 0 0"/><mass value="0.045314"/>
      <inertia ixx="3.3141e-05" ixy="-3.9576e-07" ixz="-7.8550e-08" iyy="1.7418e-05" iyz="-4.3754e-06" izz="2.3639e-05"/></inertial>
    <visual name="gripper_base"><origin xyz="0 0 0" rpy="0 -0 0"/><geometry><mesh filename="package://aquabot_description/meshes/gripper_base.stl" scale="0.001 0.001 0.001"/></geometry><material name="gripper_base_mat"/></visual>
    <visual name="horn_arm_wrist"><origin xyz="0 0.01675 0" rpy="-1.570796327 -1.570796327 0"/><geometry><mesh filename="package://aquabot_description/meshes/horn_mg90s.stl" scale="0.001 0.001 0.001"/></geometry><material name="horn_mg90s_mat"/></visual>
    <visual name="servo_gripper"><origin xyz="0 0 -0.048" rpy="3.141592654 -0 1.570796327"/><geometry><mesh filename="package://aquabot_description/meshes/servo_mg90s.stl" scale="0.001 0.001 0.001"/></geometry><material name="servo_mg90s_mat"/></visual>
    <visual name="rod_gripper_upper"><origin xyz="0.008 0 -0.066" rpy="0 -0 0"/><geometry><mesh filename="package://aquabot_description/meshes/rod_3x74.stl" scale="0.001 0.001 0.001"/></geometry><material name="rod_3x74_mat"/></visual>
    <visual name="rod_gripper_lower"><origin xyz="-0.008 0 -0.066" rpy="0 -0 0"/><geometry><mesh filename="package://aquabot_description/meshes/rod_3x74.stl" scale="0.001 0.001 0.001"/></geometry><material name="rod_3x74_mat"/></visual>
    <visual name="nozzle"><origin xyz="-0.02 0 -0.058" rpy="0 -0 0"/><geometry><mesh filename="package://aquabot_description/meshes/nozzle_brass.stl" scale="0.001 0.001 0.001"/></geometry><material name="nozzle_brass_mat"/></visual>
  </link>
  <joint name="arm_wrist" type="revolute">
    <parent link="arm_fore"/><child link="arm_wrist"/>
    <origin xyz="0 0 -0.115" rpy="0 -0 0"/><axis xyz="0 1 0"/>
    <limit lower="-1.74533" upper="1.74533" effort="0.216" velocity="10.50"/>
  </joint>
  <link name="jaw_a">
    <inertial><origin xyz="0.002562670638 -0.002186300298 -0.06708734972" rpy="0 0 0"/><mass value="0.004481"/>
      <inertia ixx="5.4409e-07" ixy="-1.3740e-07" ixz="-9.2872e-08" iyy="5.7296e-07" iyz="-8.0937e-08" izz="7.3782e-07"/></inertial>
    <visual name="gripper_jaw_a"><origin xyz="0 0 0" rpy="0 -0 0"/><geometry><mesh filename="package://aquabot_description/meshes/gripper_jaw.stl" scale="0.001 0.001 0.001"/></geometry><material name="gripper_jaw_mat"/></visual>
  </link>
  <joint name="grip_a" type="prismatic">
    <parent link="arm_wrist"/><child link="jaw_a"/>
    <origin xyz="0 0 0" rpy="0 -0 0"/><axis xyz="0 -1 0"/>
    <limit lower="0.00000" upper="0.02000" effort="18.000" velocity="0.06"/>
  </joint>
  <link name="jaw_b">
    <inertial><origin xyz="0.002562670638 -0.002186300298 -0.06708734972" rpy="0 0 0"/><mass value="0.004481"/>
      <inertia ixx="5.4409e-07" ixy="-1.3740e-07" ixz="-9.2872e-08" iyy="5.7296e-07" iyz="-8.0937e-08" izz="7.3782e-07"/></inertial>
    <visual name="gripper_jaw_b"><origin xyz="0 0 0" rpy="0 -0 0"/><geometry><mesh filename="package://aquabot_description/meshes/gripper_jaw.stl" scale="0.001 0.001 0.001"/></geometry><material name="gripper_jaw_mat"/></visual>
  </link>
  <joint name="grip_b" type="prismatic">
    <parent link="arm_wrist"/><child link="jaw_b"/>
    <origin xyz="0 0 0" rpy="0 -0 3.141592654"/><axis xyz="0 -1 0"/>
    <limit lower="0.00000" upper="0.02000" effort="18.000" velocity="0.06"/>
    <mimic joint="grip_a" multiplier="1.000000" offset="0"/>
  </joint>
  <link name="pinion">
    <inertial><origin xyz="-4.131012936e-19 1.435697068e-19 -0.05708049014" rpy="0 0 0"/><mass value="0.003272"/>
      <inertia ixx="1.0283e-07" ixy="6.5118e-24" ixz="-2.3646e-22" iyy="1.0283e-07" iyz="-2.4615e-23" izz="1.6453e-07"/></inertial>
    <visual name="gripper_pinion"><origin xyz="0 0 0" rpy="0 -0 0"/><geometry><mesh filename="package://aquabot_description/meshes/gripper_pinion.stl" scale="0.001 0.001 0.001"/></geometry><material name="gripper_pinion_mat"/></visual>
    <visual name="horn_gripper"><origin xyz="0 0 -0.048" rpy="3.141592654 -0 1.570796327"/><geometry><mesh filename="package://aquabot_description/meshes/horn_mg90s.stl" scale="0.001 0.001 0.001"/></geometry><material name="horn_mg90s_mat"/></visual>
  </link>
  <joint name="grip_pinion" type="revolute">
    <parent link="arm_wrist"/><child link="pinion"/>
    <origin xyz="0 0 0" rpy="0 -0 0"/><axis xyz="0 0 1"/>
    <limit lower="-4.00000" upper="4.00000" effort="0.216" velocity="10.50"/>
    <mimic joint="grip_a" multiplier="-100.000000" offset="0"/>
  </joint>
</robot>
